Leo-Nicolle/opentone/README.md

# opentone

Work in progress.

This is a mp3 player in the style of an ipod classic. 

### Hardware
 - MCU: ESP32
 - Display: 2.2" LCD
 - SD Card: MicroSD
 - Audio: VS1063
 - Click wheel: MPR121

## License

- Software, firmware and docs: [MIT](LICENSE)
- Hardware (`hardware/`): [CERN-OHL-P v2](hardware/LICENSE)
- Third-party material (datasheets, vendor CAD models, footprints) keeps its own terms, see [THIRD_PARTY.md](THIRD_PARTY.md)
