Leo-Nicolle/opentone/hardware/opentone/3dmodels/README.md

# 3D models

These files are not covered by the project's CERN-OHL-P license. They keep their own terms.

## KiCad library models (`*.3dshapes/`, except `opentone.3dshapes/`)

Unmodified STEP models from the KiCad 3D library:

- Source: https://gitlab.com/kicad/libraries/kicad-packages3D
- Author: the KiCad library contributors
- Revision: `master` at commit `afa6aab16f43` (retrieved 2026-11-08)
- License: CC-BY-SA 4.0 with the KiCad libraries exception, see [`LICENSE.md`](LICENSE.md)
  and [`LICENSE-CC-BY-SA-4.0.txt`](LICENSE-CC-BY-SA-4.0.txt)

## Models not stored in this repository (`opentone.3dshapes/`)

EasyEDA / LCSC models, and a copy of the Alps SKQGAF model from `hardware/3dmodels/`.
Run `node scripts/fetch-3d-models.mjs` from the repository root to get them. See
[`THIRD_PARTY.md`](../../../THIRD_PARTY.md).
