Leo-Nicolle/opentone/docs/tools/clickwheel.md

---
layout: ToolLayout
sidebar: false
aside: false
---

# Click wheel designer

Shape a capacitive click wheel footprint, check how evenly neighbouring pads blend under a finger, then export the copper and outline layers for KiCad. Every size is in millimetres.

<Clickwheel />
