Leo-Nicolle/opentone/hardware/clickwheel/clickwheel-fcu-optimised.png

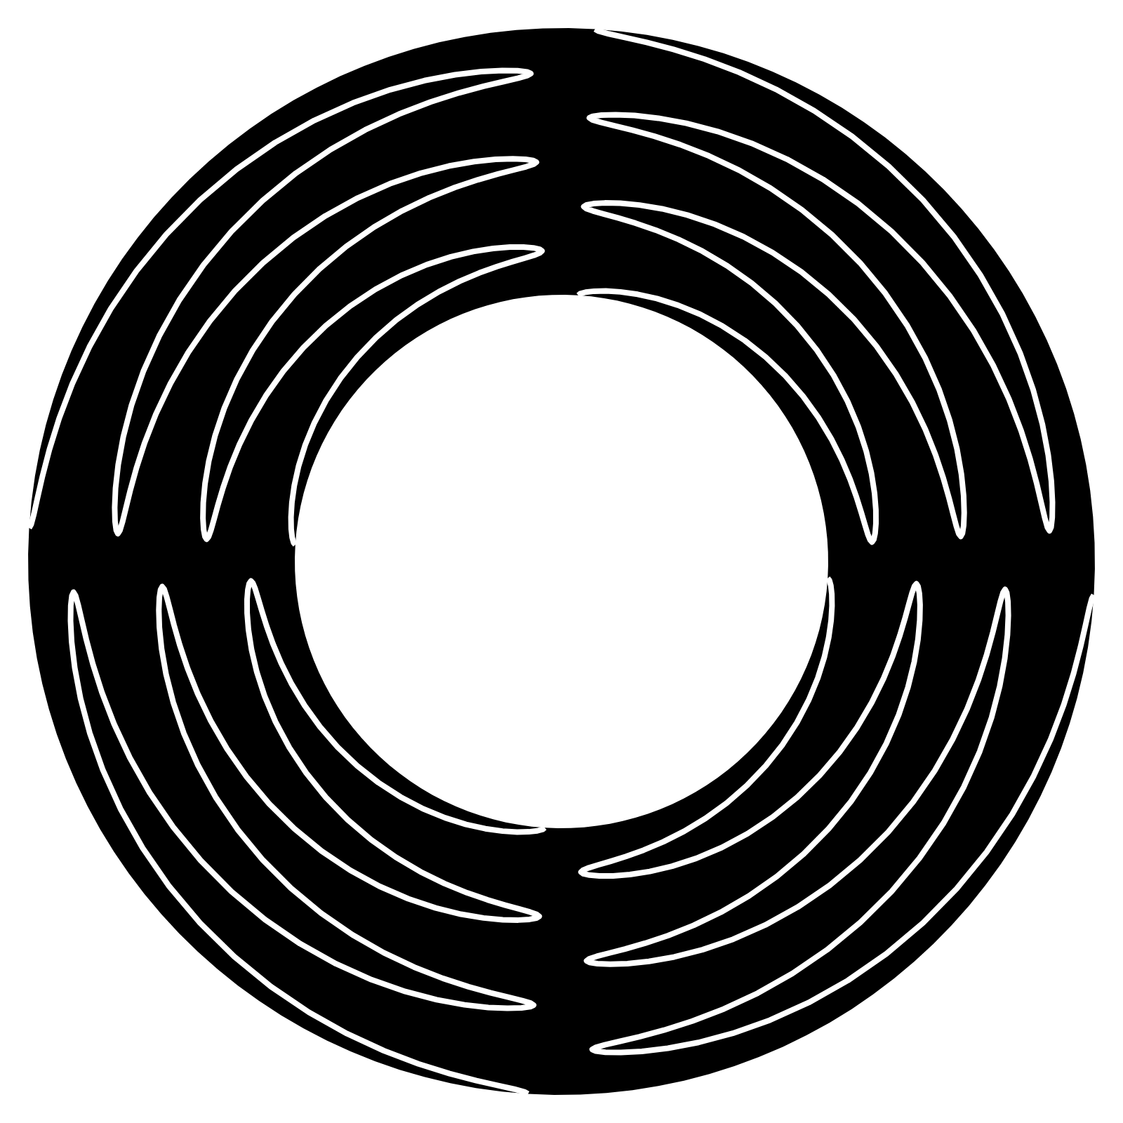
hardware/clickwheel/clickwheel-fcu-optimised.png
