Leo-Nicolle/opentone/hardware/opentone/opentone.kicad_pcb

## KiCad design hardware/opentone/opentone.kicad_pcb (2026-11-08)

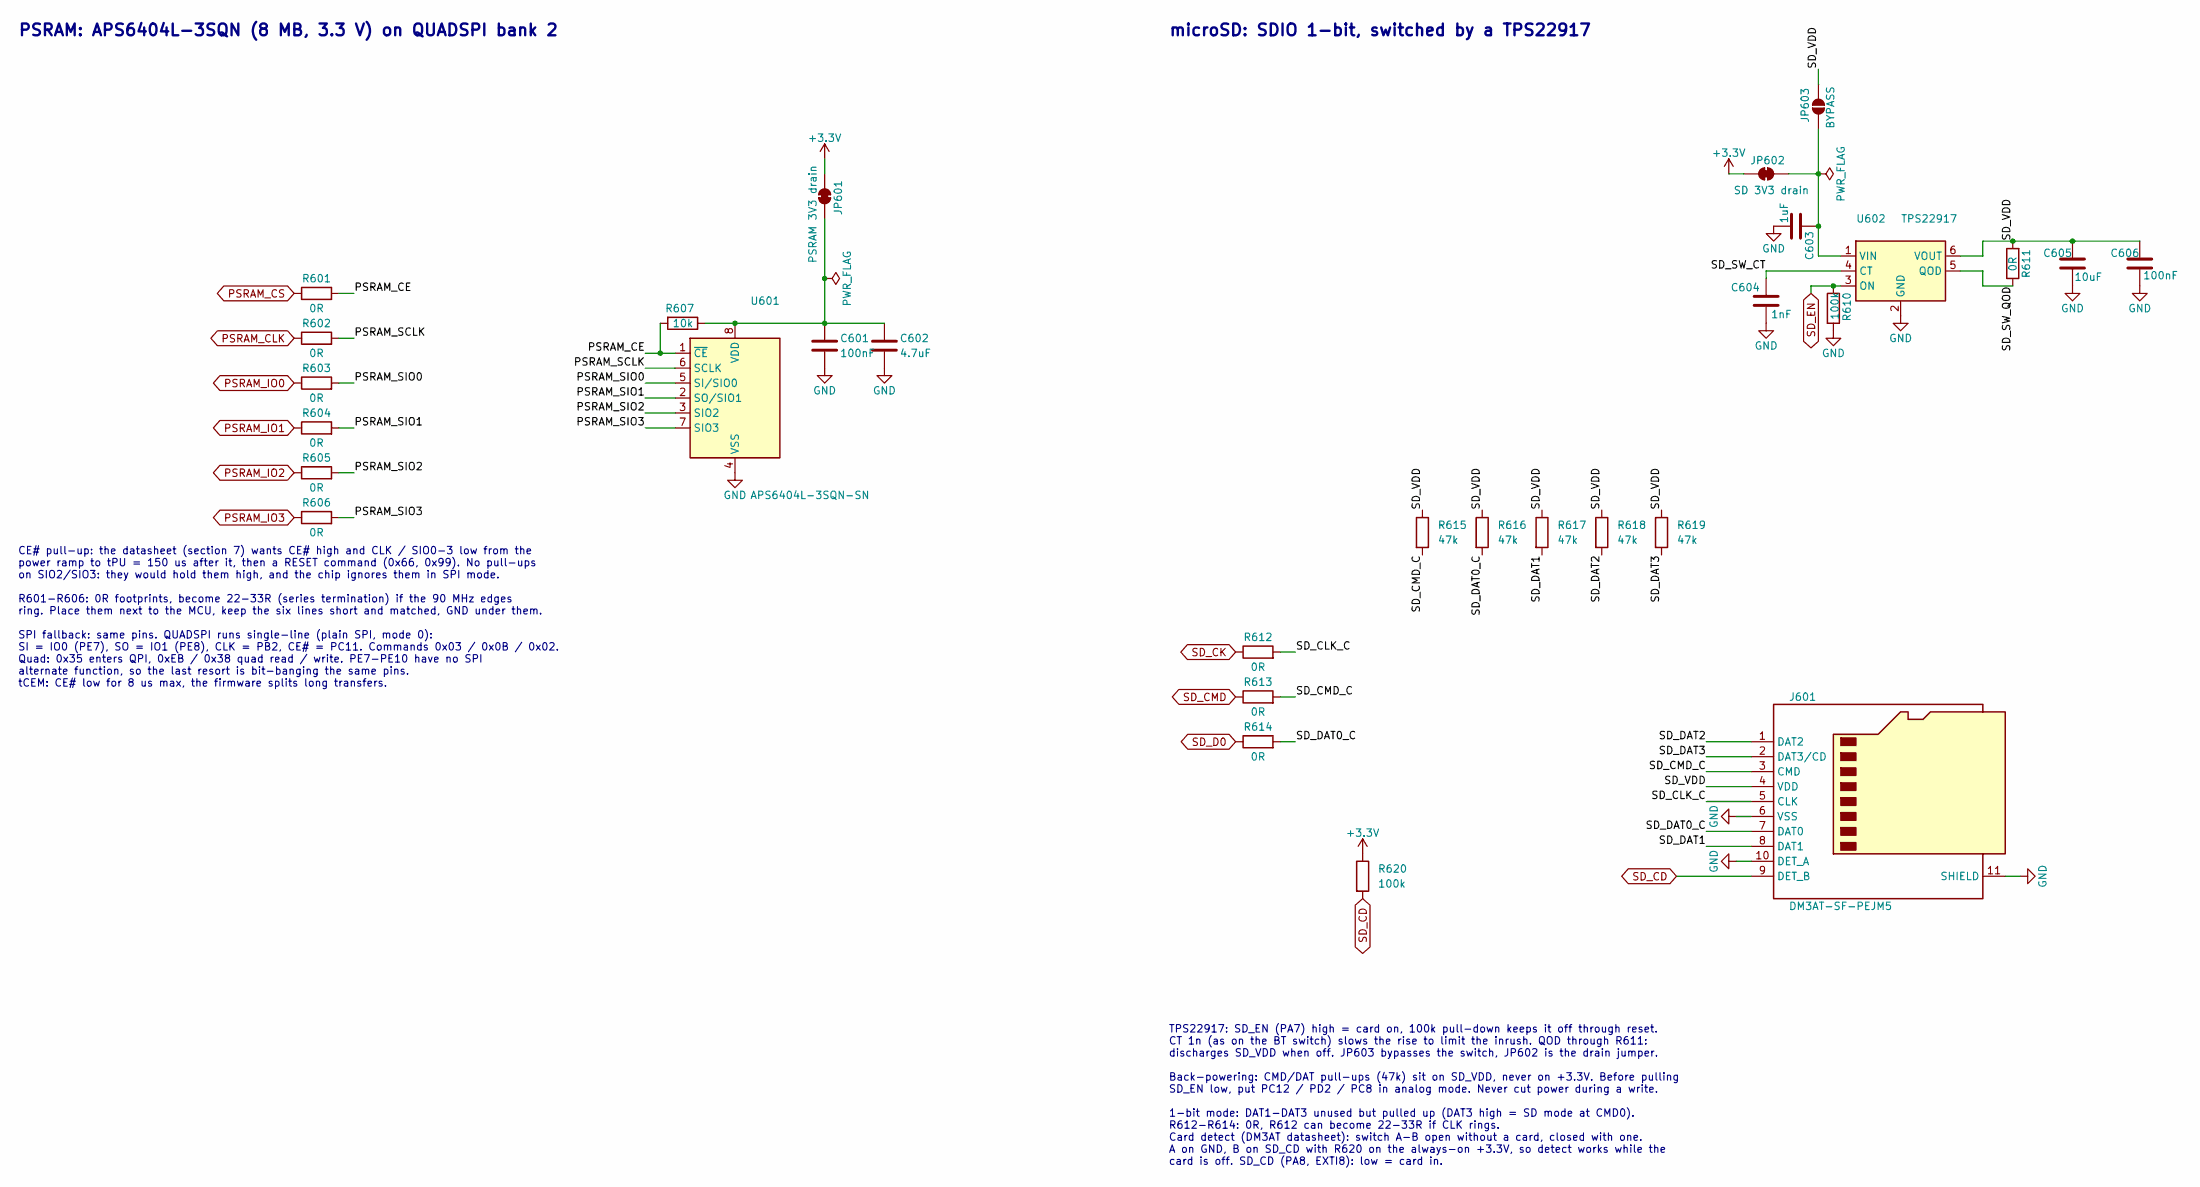
[picture p2: schematic memory.kicad_sch]

Parts:
C601, C606: 100nF; C_0603_1608Metric; Part number CC0603KRX7R9BB104; LCSC C14663
C602: 4.7uF; C_0603_1608Metric; Part number CL10A475KO8NNNC; LCSC C19666
C603: 1uF; C_0603_1608Metric; Part number CL10A105KB8NNNC; LCSC C15849
C604: 1nF; C_0603_1608Metric; Part number CL10B102KB8NNNC; LCSC C1588
C605: 10uF; C_0603_1608Metric; Part number CL10A106KP8NNNC; LCSC C19702
J601: DM3AT-SF-PEJM5; microSD_HC_Hirose_DM3AT-SF-PEJM5; Part number DM3AT-SF-PEJM5; LCSC C114218
JP601: PSRAM 3V3 drain; SolderJumper-2_P1.3mm_Bridged_RoundedPad1.0x1.5mm
JP602: SD 3V3 drain; SolderJumper-2_P1.3mm_Bridged_RoundedPad1.0x1.5mm
JP603: BYPASS; SolderJumper-2_P1.3mm_Open_RoundedPad1.0x1.5mm
R601, R602, R603, R604, R605, R606, R611, R612, R613, R614: 0R; R_0603_1608Metric; Part number 0603WAF0000T5E; LCSC C21189
R607: 10k; R_0603_1608Metric; Part number 0603WAF1002T5E; LCSC C25804
R610, R620: 100k; R_0603_1608Metric; Part number 0603WAF1003T5E; LCSC C25803
R615, R616, R617, R618, R619: 47k; R_0603_1608Metric; Part number 0603WAF4702T5E; LCSC C25819
U601: APS6404L-3SQN-SN; SOIC-8_3.9x4.9mm_P1.27mm; Part number APS6404L-3SQN-SN; LCSC C3028887
U602: TPS22917; SOT-23-6; Part number TPS22917DBVR; LCSC C2681320

Connections:
+3.3V: JP601.1 (A), JP602.1 (A), R620.1; also elsewhere on the board
/Memory/PSRAM_CE: R601.2, R607.2, U601.1 (~CE)
/Memory/PSRAM_SCLK: R602.2, U601.6 (SCLK)
/Memory/PSRAM_SIO0: R603.2, U601.5 (SI/SIO0)
/Memory/PSRAM_SIO1: R604.2, U601.2 (SO/SIO1)
/Memory/PSRAM_SIO2: R605.2, U601.3 (SIO2)
/Memory/PSRAM_SIO3: R606.2, U601.7 (SIO3)
/Memory/SD_CLK_C: J601.5 (CLK), R612.2
/Memory/SD_CMD_C: J601.3 (CMD), R613.2, R615.2
/Memory/SD_DAT0_C: J601.7 (DAT0), R614.2, R616.2
/Memory/SD_DAT1: J601.8 (DAT1), R617.2
/Memory/SD_DAT2: J601.1 (DAT2), R618.2
/Memory/SD_DAT3: J601.2 (DAT3/CD), R619.2
/Memory/SD_SW_CT: C604.1, U602.4 (CT)
/Memory/SD_SW_QOD: R611.1, U602.5 (QOD)
/Memory/SD_VDD: C605.1, C606.1, J601.4 (VDD), JP603.2 (B), R611.2, R615.1, R616.1, R617.1, R618.1, R619.1, U602.6 (VOUT)
GND: C601.2, C602.2, C603.2, C604.2, C605.2, C606.2, J601.6 (VSS), J601.10 (DET_A), J601.11 (SHIELD), R610.2, U601.4 (VSS), U602.2 (GND); also elsewhere on the board
unnamed: C601.1, C602.1, JP601.2 (B), R607.1, U601.8 (VDD)
unnamed: C603.1, JP602.2 (B), JP603.1 (A), U602.1 (VIN)
PSRAM_CLK: R602.1; also elsewhere on the board
PSRAM_CS: R601.1; also elsewhere on the board
PSRAM_IO0: R603.1; also elsewhere on the board
PSRAM_IO1: R604.1; also elsewhere on the board
PSRAM_IO2: R605.1; also elsewhere on the board
PSRAM_IO3: R606.1; also elsewhere on the board
SD_CD: J601.9 (DET_B), R620.2; also elsewhere on the board
SD_CK: R612.1; also elsewhere on the board
SD_CMD: R613.1; also elsewhere on the board
SD_D0: R614.1; also elsewhere on the board
SD_EN: R610.1, U602.3 (ON); also elsewhere on the board

Notes on the sheet:
microSD: SDIO 1-bit, switched by a TPS22917
TPS22917: SD_EN (PA7) high = card on, 100k pull-down keeps it off through reset. CT 1n (as on the BT switch) slows the rise to limit the inrush. QOD through R611: discharges SD_VDD when off. JP603 bypasses the switch, JP602 is the drain jumper. Back-powering: CMD/DAT pull-ups (47k) sit on SD_VDD, n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
CE# pull-up: the datasheet (section 7) wants CE# high and CLK / SIO0-3 low from the power ramp to tPU = 150 us after it, then a RESET command (0x66, 0x99). No pull-ups on SIO2/SIO3: they would hold them high, and the chip ignores them in SPI mode. R601-R606: 0R footprints, become 22-33R (series ter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
PSRAM: APS6404L-3SQN (8 MB, 3.3 V) on QUADSPI bank 2

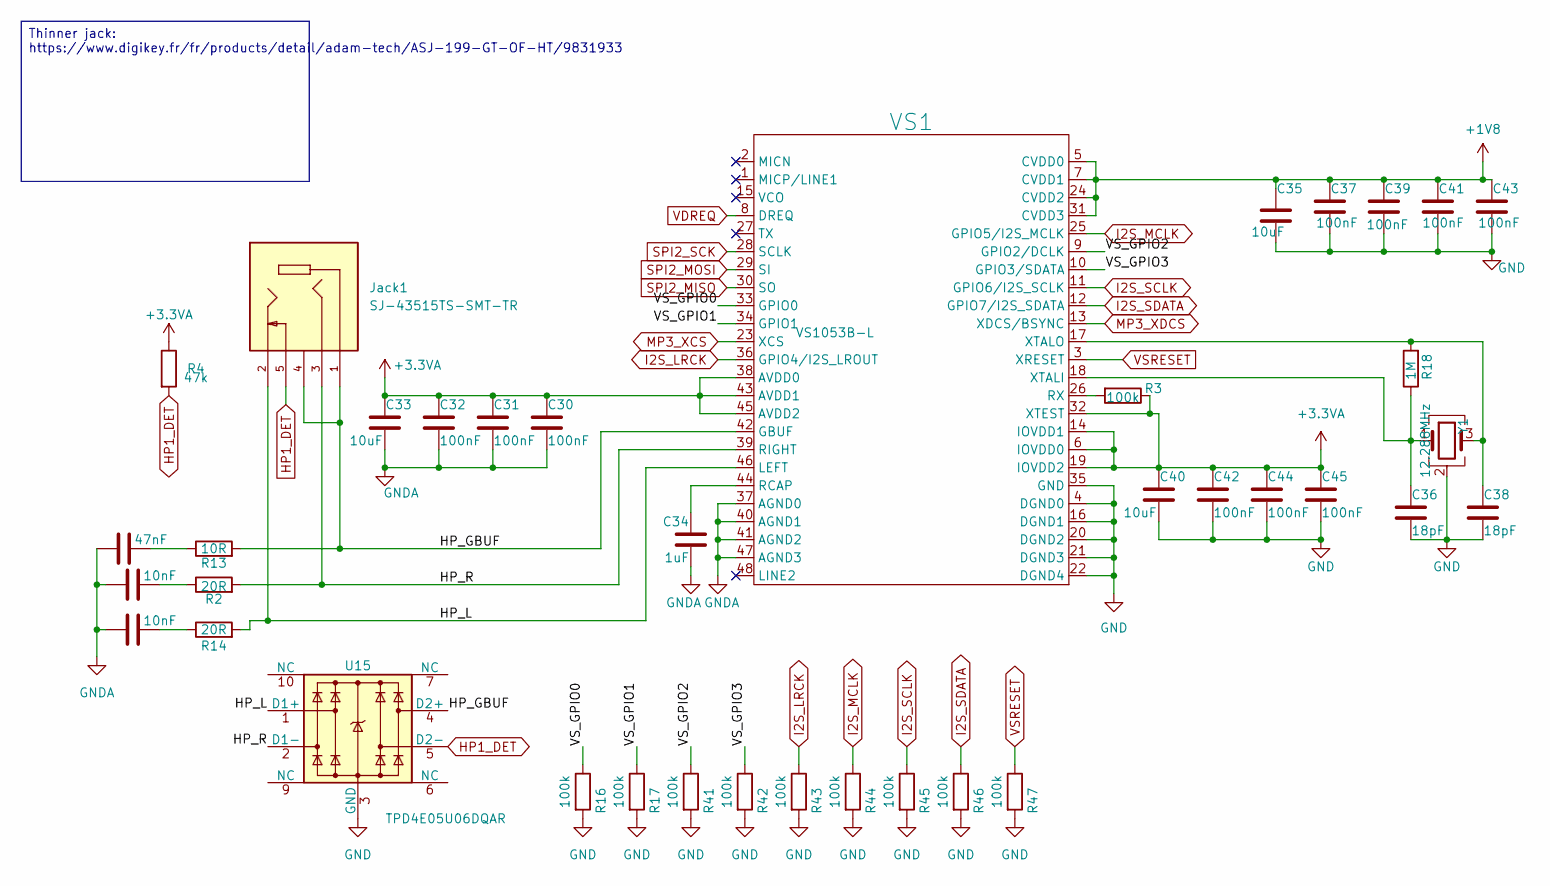
[picture p3: schematic audio.kicad_sch]

Parts:
C3, C29: 10nF; C_0603_1608Metric; Part number GRM1885C1H103JA01D; LCSC C85973
C9: 47nF; C_1206_3216Metric; Part number GRM31M5C1H473JA01L; LCSC C21812
C30, C31, C37, C39, C41, C42, C43, C44, C45: 100nF; C_0603_1608Metric; Part number CC0603KRX7R9BB104; LCSC C14663
C32: 100nF; C_0402_1005Metric; Part number CL05B104KO5NNNC; LCSC C1525
C33, C35, C40: 10uF; C_0603_1608Metric; Part number CL10A106KP8NNNC; LCSC C19702
C34: 1uF; C_0603_1608Metric; Part number CL10A105KB8NNNC; LCSC C15849
C36, C38: 18pF; C_0603_1608Metric; Part number CL10C180JB8NNNC; LCSC C1647
Jack1: SJ-43515TS-SMT-TR; CUI_SJ-43515TS-SMT-TR; Part number SJ-43515TS-SMT-TR; LCSC C5353507
R2, R14: 20R; R_0603_1608Metric; Part number 0603WAF200JT5E; LCSC C22950
R3, R16, R17, R41, R42, R43, R44, R45, R46, R47: 100k; R_0603_1608Metric; Part number 0603WAF1003T5E; LCSC C25803
R4: 47k; R_0603_1608Metric; Part number 0603WAF4702T5E; LCSC C25819
R13: 10R; R_0603_1608Metric; Part number 0603WAF100JT5E; LCSC C22859
R18: 1M; R_0603_1608Metric; Part number 0603WAF1004T5E; LCSC C22935
U15: TPD4E05U06DQAR; USON-10_2.5x1.0mm_P0.5mm; Part number TPD4E05U06DQAR; LCSC C138714
VS1: VS1053B-L; LQFP-48_7x7mm_P0.5mm; Part number VS1053B-L; LCSC C9922
Y1: 12.288MHz; Crystal_SMD_3225-4Pin_3.2x2.5mm; Part number TXM12.288M0004322FBCDO00T; LCSC C362472

Connections:
+1V8: C35.1, C37.1, C39.1, C41.1, C43.1, VS1.5 (CVDD0), VS1.7 (CVDD1), VS1.24 (CVDD2), VS1.31 (CVDD3); also elsewhere on the board
+3.3VA: C30.1, C31.1, C32.1, C33.1, C40.1, C42.1, C44.1, C45.1, R3.1, R4.1, VS1.6 (IOVDD0), VS1.14 (IOVDD1), VS1.19 (IOVDD2), VS1.32 (XTEST), VS1.38 (AVDD0), VS1.43 (AVDD1), VS1.45 (AVDD2); also elsewhere on the board
/Audio/HP_GBUF: Jack1.1, Jack1.4, R13.2, U15.4 (D2+), VS1.42 (GBUF)
/Audio/HP_L: Jack1.2, R14.2, U15.1 (D1+), VS1.46 (LEFT)
/Audio/HP_R: Jack1.3, R2.2, U15.2 (D1-), VS1.39 (RIGHT)
/Audio/VS_GPIO0: R16.1, VS1.33 (GPIO0)
/Audio/VS_GPIO1: R17.1, VS1.34 (GPIO1)
/Audio/VS_GPIO2: R41.1, VS1.9 (GPIO2/DCLK)
/Audio/VS_GPIO3: R42.1, VS1.10 (GPIO3/SDATA)
GND: C35.2, C36.2, C37.2, C38.2, C39.2, C40.2, C41.2, C42.2, C43.2, C44.2, C45.2, R16.2, R17.2, R41.2, R42.2, R43.2, R44.2, R45.2, R46.2, R47.2, U15.3 (GND), U15.8 (GND), VS1.4 (DGND0), VS1.16 (DGND1), VS1.20 (DGND2), VS1.21 (DGND3), VS1.22 (DGND4), VS1.35 (GND), Y1.2 (G), Y1.4 (G); also elsewhere on the board
GNDA: C3.1, C9.1, C29.1, C30.2, C31.2, C32.2, C33.2, C34.2, VS1.37 (AGND0), VS1.40 (AGND1), VS1.41 (AGND2), VS1.47 (AGND3); also elsewhere on the board
HP1_DET: Jack1.5, R4.2, U15.5 (D2-); also elsewhere on the board
I2S_LRCK: R43.1, VS1.36 (GPIO4/I2S_LROUT); also elsewhere on the board
I2S_MCLK: R44.1, VS1.25 (GPIO5/I2S_MCLK); also elsewhere on the board
I2S_SCLK: R45.1, VS1.11 (GPIO6/I2S_SCLK); also elsewhere on the board
I2S_SDATA: R46.1, VS1.12 (GPIO7/I2S_SDATA); also elsewhere on the board
MP3_XCS: VS1.23 (XCS); also elsewhere on the board
MP3_XDCS: VS1.13 (XDCS/BSYNC); also elsewhere on the board
unnamed: C3.2, R2.1
unnamed: C9.2, R13.1
unnamed: C29.2, R14.1
unnamed: C34.1, VS1.44 (RCAP)
unnamed: R3.2, VS1.26 (RX)
unnamed: C36.1, R18.1, VS1.18 (XTALI), Y1.1
unnamed: C38.1, R18.2, VS1.17 (XTALO), Y1.3
SPI2_MISO: VS1.30 (SO); also elsewhere on the board
SPI2_MOSI: VS1.29 (SI); also elsewhere on the board
SPI2_SCK: VS1.28 (SCLK); also elsewhere on the board
VDREQ: VS1.8 (DREQ); also elsewhere on the board
VSRESET: R47.1, VS1.3 (XRESET); also elsewhere on the board

Notes on the sheet:
Thinner jack: https://www.digikey.fr/fr/products/detail/adam-tech/ASJ-199-GT-OF-HT/9831933

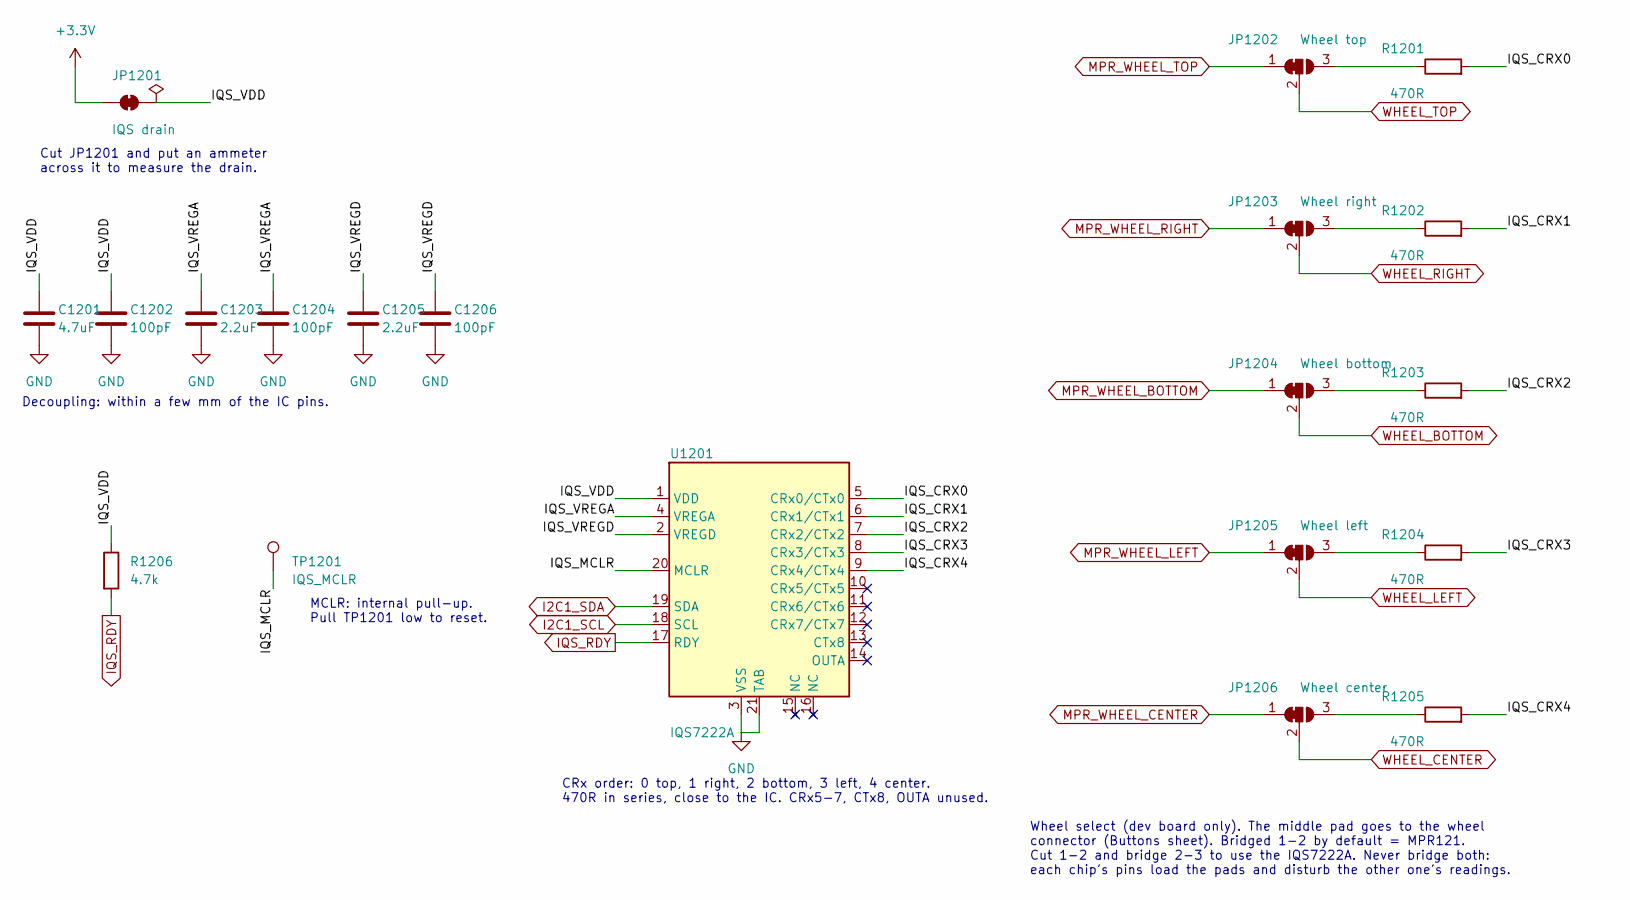
[picture p4: schematic touch.kicad_sch]

Parts:
C1201: 4.7uF; C_0603_1608Metric; Part number CL10A475KO8NNNC; LCSC C19666
C1202, C1204, C1206: 100pF; C_0603_1608Metric; Part number CL10C101JB8NNNC; LCSC C14858
C1203, C1205: 2.2uF; C_0603_1608Metric; Part number CL10A225KO8NNNC; LCSC C23630
JP1201: IQS drain; SolderJumper-2_P1.3mm_Bridged_RoundedPad1.0x1.5mm
JP1202: Wheel top; SolderJumper-3_P1.3mm_Bridged12_RoundedPad1.0x1.5mm
JP1203: Wheel right; SolderJumper-3_P1.3mm_Bridged12_RoundedPad1.0x1.5mm
JP1204: Wheel bottom; SolderJumper-3_P1.3mm_Bridged12_RoundedPad1.0x1.5mm
JP1205: Wheel left; SolderJumper-3_P1.3mm_Bridged12_RoundedPad1.0x1.5mm
JP1206: Wheel center; SolderJumper-3_P1.3mm_Bridged12_RoundedPad1.0x1.5mm
R1201, R1202, R1203, R1204, R1205: 470R; R_0603_1608Metric; Part number 0603WAF4700T5E; LCSC C23179
R1206: 4.7k; R_0603_1608Metric; Part number 0603WAF4701T5E; LCSC C23162
TP1201: IQS_MCLR; TestPoint_Pad_D1.0mm
U1201: IQS7222A; VQFN-20-1EP_3x3mm_P0.4mm_EP1.7x1.7mm; Part number IQS7222A001QNR; LCSC C3827627

Connections:
+3.3V: JP1201.1 (A); also elsewhere on the board
/Touch/IQS_CRX0: R1201.2, U1201.5 (CRx0/CTx0)
/Touch/IQS_CRX1: R1202.2, U1201.6 (CRx1/CTx1)
/Touch/IQS_CRX2: R1203.2, U1201.7 (CRx2/CTx2)
/Touch/IQS_CRX3: R1204.2, U1201.8 (CRx3/CTx3)
/Touch/IQS_CRX4: R1205.2, U1201.9 (CRx4/CTx4)
/Touch/IQS_MCLR: TP1201.1 (1_1), U1201.20 (MCLR)
/Touch/IQS_VDD: C1201.1, C1202.1, JP1201.2 (B), R1206.1, U1201.1 (VDD)
/Touch/IQS_VREGA: C1203.1, C1204.1, U1201.4 (VREGA)
/Touch/IQS_VREGD: C1205.1, C1206.1, U1201.2 (VREGD)
GND: C1201.2, C1202.2, C1203.2, C1204.2, C1205.2, C1206.2, U1201.3 (VSS), U1201.21 (TAB); also elsewhere on the board
I2C1_SCL: U1201.18 (SCL); also elsewhere on the board
I2C1_SDA: U1201.19 (SDA); also elsewhere on the board
IQS_RDY: R1206.2, U1201.17 (RDY); also elsewhere on the board
MPR_WHEEL_BOTTOM: JP1204.1 (A); also elsewhere on the board
MPR_WHEEL_CENTER: JP1206.1 (A); also elsewhere on the board
MPR_WHEEL_LEFT: JP1205.1 (A); also elsewhere on the board
MPR_WHEEL_RIGHT: JP1203.1 (A); also elsewhere on the board
MPR_WHEEL_TOP: JP1202.1 (A); also elsewhere on the board
unnamed: JP1202.3 (B), R1201.1
unnamed: JP1203.3 (B), R1202.1
unnamed: JP1204.3 (B), R1203.1
unnamed: JP1205.3 (B), R1204.1
unnamed: JP1206.3 (B), R1205.1
WHEEL_BOTTOM: JP1204.2 (C); also elsewhere on the board
WHEEL_CENTER: JP1206.2 (C); also elsewhere on the board
WHEEL_LEFT: JP1205.2 (C); also elsewhere on the board
WHEEL_RIGHT: JP1203.2 (C); also elsewhere on the board
WHEEL_TOP: JP1202.2 (C); also elsewhere on the board

Notes on the sheet:
MCLR: internal pull-up. Pull TP1201 low to reset.
Decoupling: within a few mm of the IC pins.
CRx order: 0 top, 1 right, 2 bottom, 3 left, 4 center. 470R in series, close to the IC. CRx5-7, CTx8, OUTA unused.
Cut JP1201 and put an ammeter across it to measure the drain.
Wheel select (dev board only). The middle pad goes to the wheel connector (Buttons sheet). Bridged 1-2 by default = MPR121. Cut 1-2 and bridge 2-3 to use the IQS7222A. Never bridge both: each chip's pins load the pads and disturb the other one's readings.

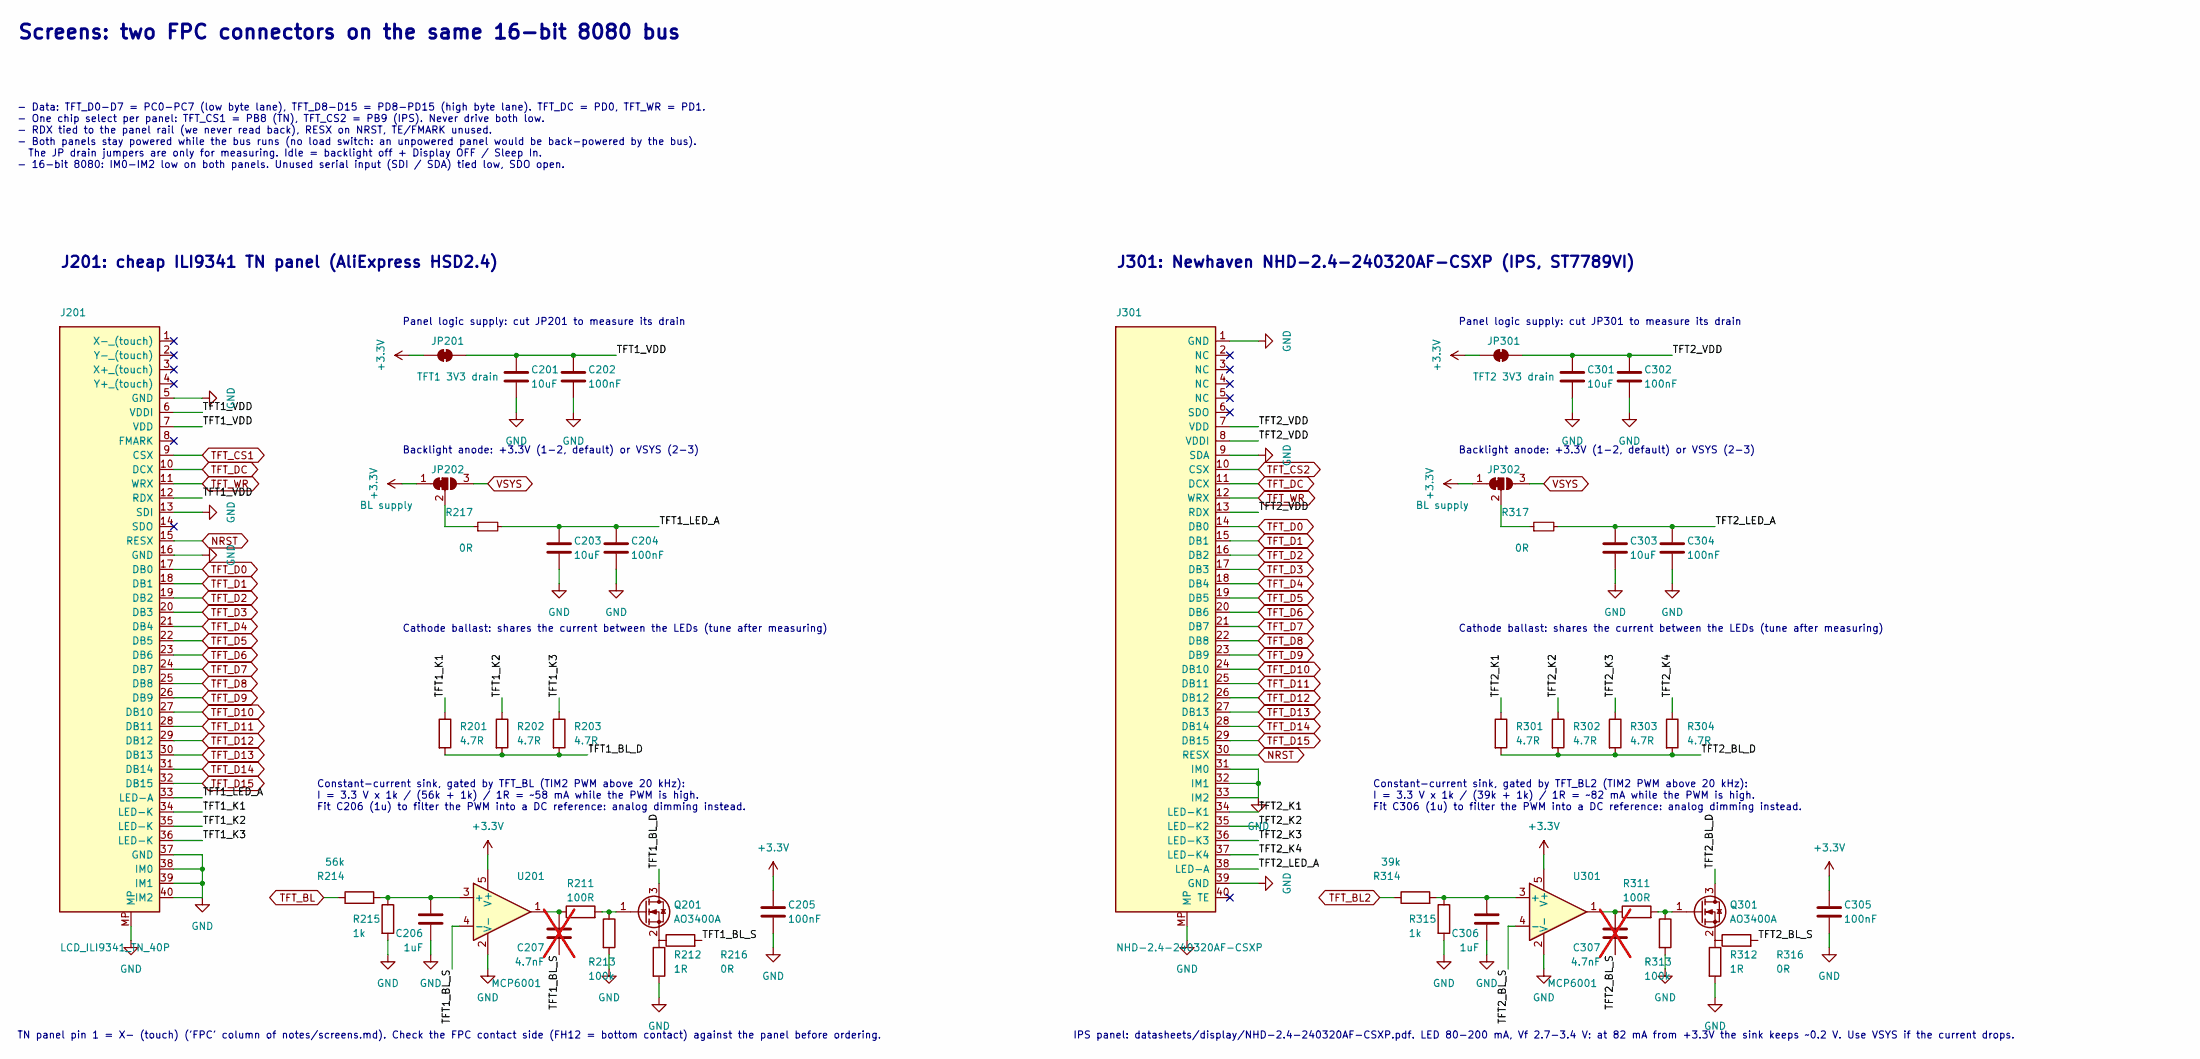
[picture p5: schematic screens.kicad_sch]

Parts:
C201, C301: 10uF; C_0603_1608Metric; Part number CL10A106KP8NNNC; LCSC C19702
C202, C204, C205, C302, C304, C305: 100nF; C_0603_1608Metric; Part number CC0603KRX7R9BB104; LCSC C14663
C203, C303: 10uF; C_0603_1608Metric; Part number CL10A106MA8NRNC; LCSC C96446
C206, C306: 1uF; C_0603_1608Metric; Part number CL10A105KB8NNNC; LCSC C15849
C207, C307: 4.7nF; C_0603_1608Metric; Part number 0603B472K500NT; LCSC C53987; not fitted
J201: LCD_ILI9341_TN_40P; Hirose_FH12-40S-0.5SH_1x40-1MP_P0.50mm_Horizontal; Part number FH12-40S-0.5SH(55); LCSC C202114
J301: NHD-2.4-240320AF-CSXP; Hirose_FH12-40S-0.5SH_1x40-1MP_P0.50mm_Horizontal; Part number FH12-40S-0.5SH(55); LCSC C202114
JP201: TFT1 3V3 drain; SolderJumper-2_P1.3mm_Bridged_RoundedPad1.0x1.5mm
JP202, JP302: BL supply; SolderJumper-3_P1.3mm_Bridged12_RoundedPad1.0x1.5mm
JP301: TFT2 3V3 drain; SolderJumper-2_P1.3mm_Bridged_RoundedPad1.0x1.5mm
Q201, Q301: AO3400A; SOT-23; Part number AO3400A; LCSC C20917
R201, R202, R203, R301, R302, R303, R304: 4.7R; R_0603_1608Metric; Part number 0603WAF470KT5E; LCSC C23164
R211, R311: 100R; R_0603_1608Metric; Part number 0603WAF1000T5E; LCSC C22775
R212, R312: 1R; R_0603_1608Metric; Part number 0603WAF100KT5E; LCSC C22936
R213, R313: 100k; R_0603_1608Metric; Part number 0603WAF1003T5E; LCSC C25803
R214: 56k; R_0603_1608Metric; Part number 0603WAF5602T5E; LCSC C23206
R215, R315: 1k; R_0603_1608Metric; Part number 0603WAF1001T5E; LCSC C21190
R216, R217, R316, R317: 0R; R_0603_1608Metric; Part number 0603WAF0000T5E; LCSC C21189
R314: 39k; R_0603_1608Metric; Part number 0603WAF3902T5E; LCSC C23153
U201, U301: MCP6001; SOT-23-5; Part number MCP6001T-I/OT; LCSC C116490

Connections:
+3.3V: C205.1, C305.1, JP201.1 (A), JP202.1 (A), JP301.1 (A), JP302.1 (A), U201.5 (V+), U301.5 (V+); also elsewhere on the board
/Screens/TFT1_BL_D: Q201.3 (D), R201.2, R202.2, R203.2
/Screens/TFT1_BL_S: C207.2, R216.2, U201.4 (-)
/Screens/TFT1_K1: J201.34 (LED-K), R201.1
/Screens/TFT1_K2: J201.35 (LED-K), R202.1
/Screens/TFT1_K3: J201.36 (LED-K), R203.1
/Screens/TFT1_LED_A: C203.1, C204.1, J201.33 (LED-A), R217.2
/Screens/TFT1_VDD: C201.1, C202.1, J201.6 (VDDI), J201.7 (VDD), J201.12 (RDX), JP201.2 (B)
/Screens/TFT2_BL_D: Q301.3 (D), R301.2, R302.2, R303.2, R304.2
/Screens/TFT2_BL_S: C307.2, R316.2, U301.4 (-)
/Screens/TFT2_K1: J301.34 (LED-K1), R301.1
/Screens/TFT2_K2: J301.35 (LED-K2), R302.1
/Screens/TFT2_K3: J301.36 (LED-K3), R303.1
/Screens/TFT2_K4: J301.37 (LED-K4), R304.1
/Screens/TFT2_LED_A: C303.1, C304.1, J301.38 (LED-A), R317.2
/Screens/TFT2_VDD: C301.1, C302.1, J301.7 (VDD), J301.8 (VDDI), J301.13 (RDX), JP301.2 (B)
GND: C201.2, C202.2, C203.2, C204.2, C205.2, C206.2, C301.2, C302.2, C303.2, C304.2, C305.2, C306.2, J201.5 (GND), J201.13 (SDI), J201.16 (GND), J201.37 (GND), J201.38 (IM0), J201.39 (IM1), J201.40 (IM2), J201.MP, J301.1 (GND), J301.9 (SDA), J301.31 (IM0), J301.32 (IM1), J301.33 (IM2), J301.39 (GND), J301.MP, R212.2, R213.2, R215.2, R312.2, R313.2, R315.2, U201.2 (V-), U301.2 (V-); also elsewhere on the board
NRST: J201.15 (RESX), J301.30 (RESX); also elsewhere on the board
unnamed: C207.1, R211.1, U201.1
unnamed: C307.1, R311.1, U301.1
unnamed: JP202.2 (C), R217.1
unnamed: JP302.2 (C), R317.1
unnamed: Q201.1 (G), R211.2, R213.1
unnamed: Q201.2 (S), R212.1, R216.1
unnamed: Q301.1 (G), R311.2, R313.1
unnamed: Q301.2 (S), R312.1, R316.1
unnamed: C206.1, R214.2, R215.1, U201.3 (+)
unnamed: C306.1, R314.2, R315.1, U301.3 (+)
TFT_BL: R214.1; also elsewhere on the board
TFT_BL2: R314.1; also elsewhere on the board
TFT_CS1: J201.9 (CSX); also elsewhere on the board
TFT_CS2: J301.10 (CSX); also elsewhere on the board
TFT_D0: J201.17 (DB0), J301.14 (DB0); also elsewhere on the board
TFT_D1: J201.18 (DB1), J301.15 (DB1); also elsewhere on the board
TFT_D2: J201.19 (DB2), J301.16 (DB2); also elsewhere on the board
TFT_D3: J201.20 (DB3), J301.17 (DB3); also elsewhere on the board
TFT_D4: J201.21 (DB4), J301.18 (DB4); also elsewhere on the board
TFT_D5: J201.22 (DB5), J301.19 (DB5); also elsewhere on the board
TFT_D6: J201.23 (DB6), J301.20 (DB6); also elsewhere on the board
TFT_D7: J201.24 (DB7), J301.21 (DB7); also elsewhere on the board
TFT_D8: J201.25 (DB8), J301.22 (DB8); also elsewhere on the board
TFT_D9: J201.26 (DB9), J301.23 (DB9); also elsewhere on the board
TFT_D10: J201.27 (DB10), J301.24 (DB10); also elsewhere on the board
TFT_D11: J201.28 (DB11), J301.25 (DB11); also elsewhere on the board
TFT_D12: J201.29 (DB12), J301.26 (DB12); also elsewhere on the board
TFT_D13: J201.30 (DB13), J301.27 (DB13); also elsewhere on the board
TFT_D14: J201.31 (DB14), J301.28 (DB14); also elsewhere on the board
TFT_D15: J201.32 (DB15), J301.29 (DB15); also elsewhere on the board
TFT_DC: J201.10 (DCX), J301.11 (DCX); also elsewhere on the board
TFT_WR: J201.11 (WRX), J301.12 (WRX); also elsewhere on the board
VSYS: JP202.3 (B), JP302.3 (B); also elsewhere on the board

Notes on the sheet:
Panel logic supply: cut JP201 to measure its drain
TN panel pin 1 = X- (touch) ('FPC' column of notes/screens.md). Check the FPC contact side (FH12 = bottom contact) against the panel before ordering.
Backlight anode: +3.3V (1-2, default) or VSYS (2-3)
- Data: TFT_D0-D7 = PC0-PC7 (low byte lane), TFT_D8-D15 = PD8-PD15 (high byte lane). TFT_DC = PD0, TFT_WR = PD1. - One chip select per panel: TFT_CS1 = PB8 (TN), TFT_CS2 = PB9 (IPS). Never drive both low. - RDX tied to the panel rail (we never read back), RESX on NRST, TE/FMARK unused. - Both panel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
Constant-current sink, gated by TFT_BL (TIM2 PWM above 20 kHz): I = 3.3 V x 1k / (56k + 1k) / 1R = ~58 mA while the PWM is high. Fit C206 (1u) to filter the PWM into a DC reference: analog dimming instead.
Screens: two FPC connectors on the same 16-bit 8080 bus
IPS panel: datasheets/display/NHD-2.4-240320AF-CSXP.pdf. LED 80-200 mA, Vf 2.7-3.4 V: at 82 mA from +3.3V the sink keeps ~0.2 V. Use VSYS if the current drops.
Panel logic supply: cut JP301 to measure its drain
J201: cheap ILI9341 TN panel (AliExpress HSD2.4)
Constant-current sink, gated by TFT_BL2 (TIM2 PWM above 20 kHz): I = 3.3 V x 1k / (39k + 1k) / 1R = ~82 mA while the PWM is high. Fit C306 (1u) to filter the PWM into a DC reference: analog dimming instead.
J301: Newhaven NHD-2.4-240320AF-CSXP (IPS, ST7789VI)
Cathode ballast: shares the current between the LEDs (tune after measuring)

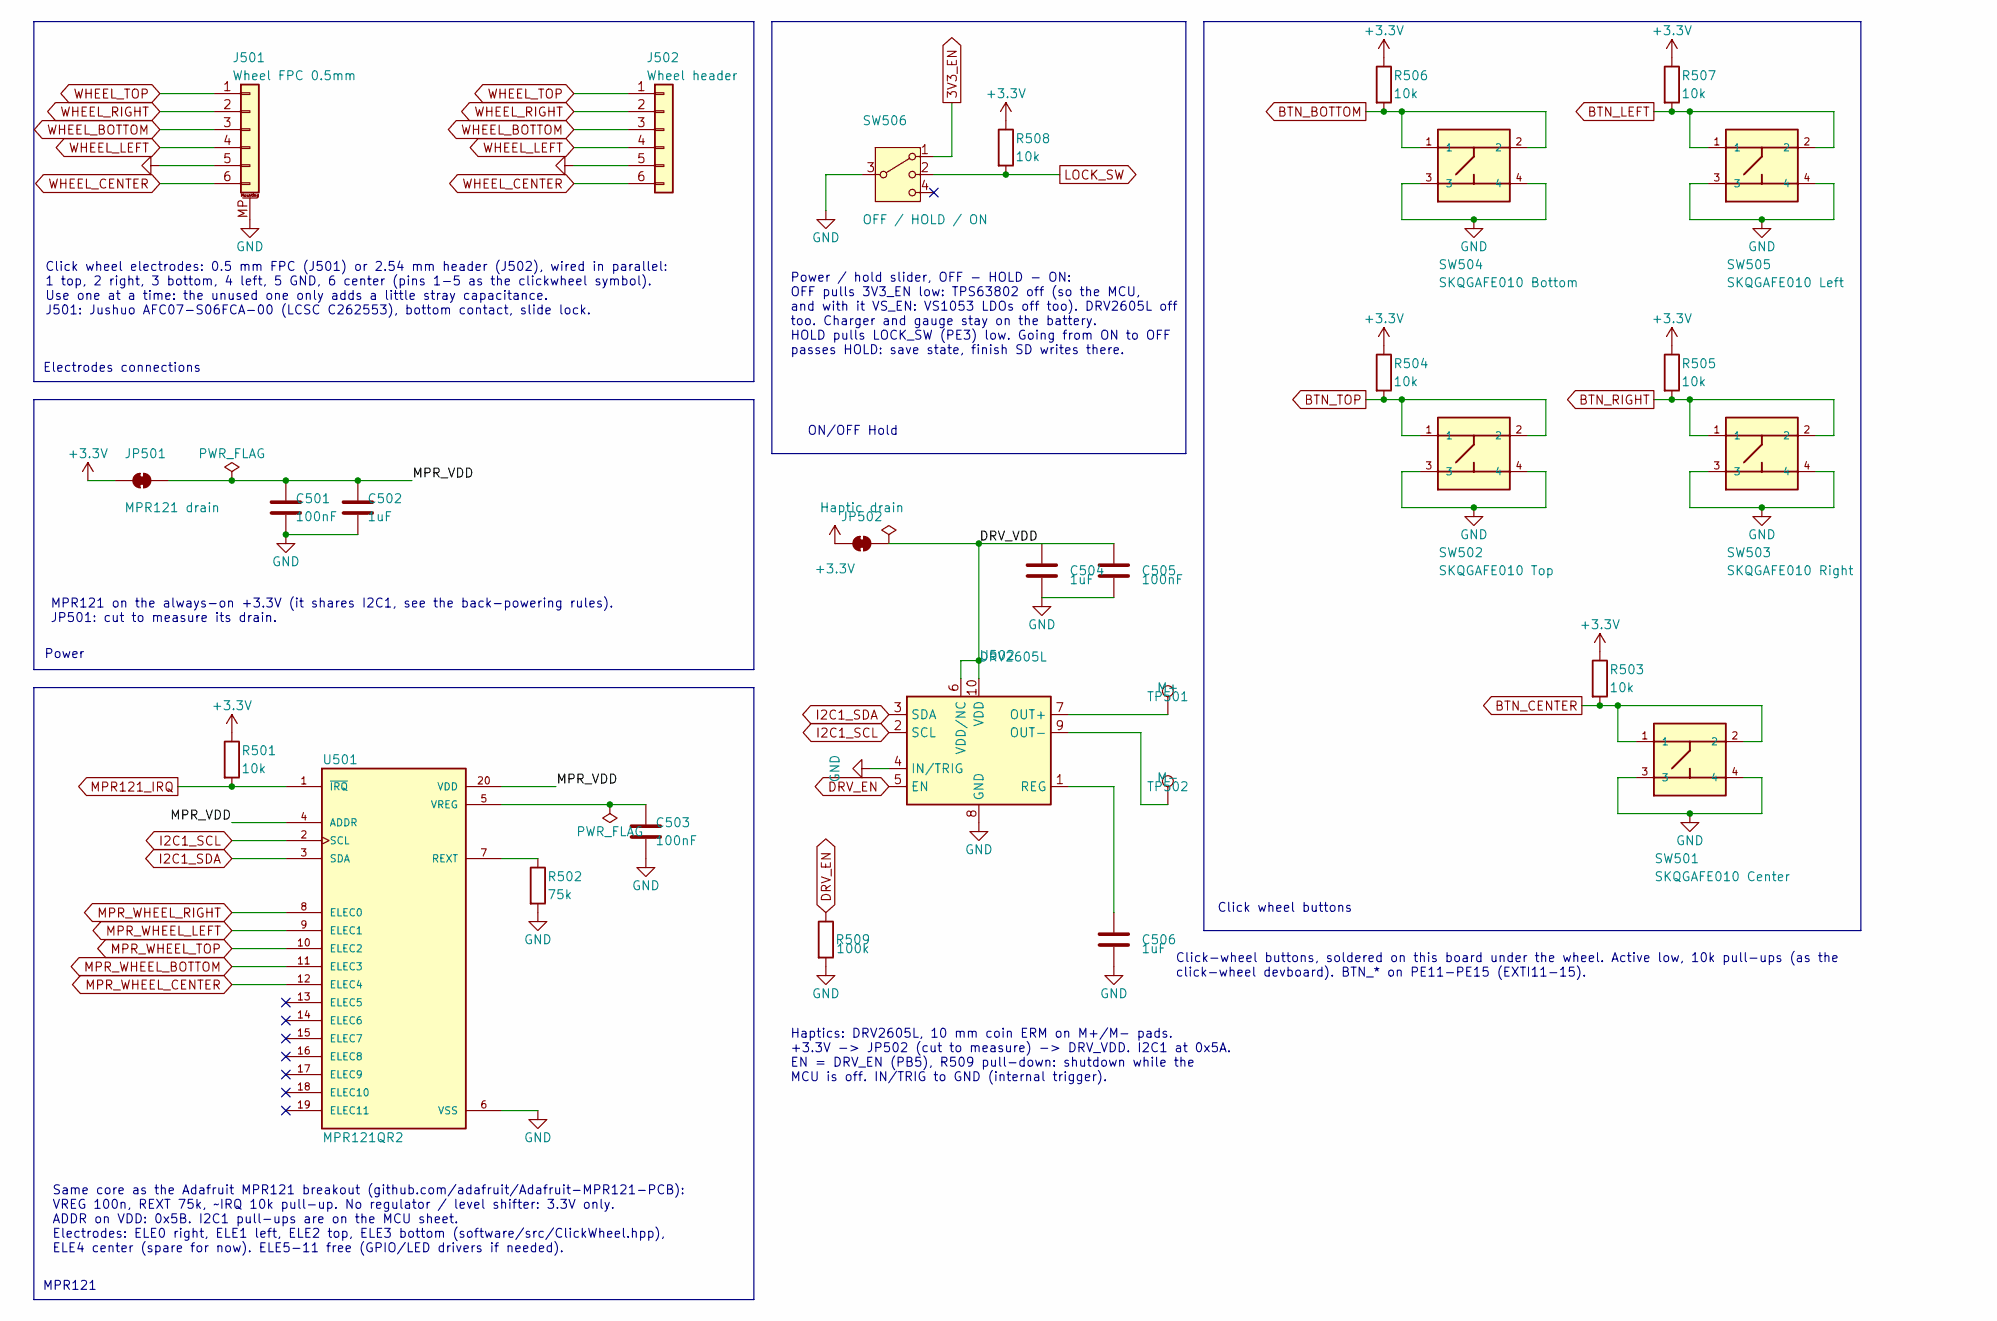
[picture p6: schematic buttons.kicad_sch]

Parts:
C501, C503, C505: 100nF; C_0603_1608Metric; Part number CC0603KRX7R9BB104; LCSC C14663
C502, C504, C506: 1uF; C_0603_1608Metric; Part number CL10A105KB8NNNC; LCSC C15849
J501: Wheel FPC 0.5mm; Jushuo_AFC07-S06FCA-00_1x6-1MP_P0.50_Horizontal; Part number AFC07-S06FCA-00; LCSC C262553
J502: Wheel header; PinHeader_1x06_P2.54mm_Vertical
JP501: MPR121 drain; SolderJumper-2_P1.3mm_Bridged_RoundedPad1.0x1.5mm
JP502: Haptic drain; SolderJumper-2_P1.3mm_Bridged_RoundedPad1.0x1.5mm
R501, R503, R504, R505, R506, R507, R508: 10k; R_0603_1608Metric; Part number 0603WAF1002T5E; LCSC C25804
R502: 75k; R_0603_1608Metric; Part number 0603WAF7502T5E; LCSC C23242
R509: 100k; R_0603_1608Metric; Part number 0603WAF1003T5E; LCSC C25803
SW501: SKQGAFE010 Center; SW_SKQGAFE010; Part number SKQGAFE010; LCSC C202424
SW502: SKQGAFE010 Top; SW_SKQGAFE010; Part number SKQGAFE010; LCSC C202424
SW503: SKQGAFE010 Right; SW_SKQGAFE010; Part number SKQGAFE010; LCSC C202424
SW504: SKQGAFE010 Bottom; SW_SKQGAFE010; Part number SKQGAFE010; LCSC C202424
SW505: SKQGAFE010 Left; SW_SKQGAFE010; Part number SKQGAFE010; LCSC C202424
SW506: OFF / HOLD / ON; SW_SP3T_PCM13; Part number PCM13SMTR; LCSC C221842
TP501: M+; TestPoint_Pad_1.5x1.5mm
TP502: M-; TestPoint_Pad_1.5x1.5mm
U501: MPR121QR2; mpr121qr2; Part number MPR121QR2; LCSC C91322
U502: DRV2605L; VSSOP-10_3x3mm_P0.5mm; Part number DRV2605LDGSR; LCSC C527464

Connections:
3V3_EN: SW506.1; also elsewhere on the board
+3.3V: JP501.1 (A), JP502.1 (A), R501.1, R503.1, R504.1, R505.1, R506.1, R507.1, R508.1; also elsewhere on the board
/Buttons/DRV_VDD: C504.1, C505.1, JP502.2 (B), U502.6 (VDD/NC), U502.10 (VDD)
/Buttons/MPR_VDD: C501.1, C502.1, JP501.2 (B), U501.4 (ADDR), U501.20 (VDD)
BTN_BOTTOM: R506.2, SW504.1, SW504.2; also elsewhere on the board
BTN_CENTER: R503.2, SW501.1, SW501.2; also elsewhere on the board
BTN_LEFT: R507.2, SW505.1, SW505.2; also elsewhere on the board
BTN_RIGHT: R505.2, SW503.1, SW503.2; also elsewhere on the board
BTN_TOP: R504.2, SW502.1, SW502.2; also elsewhere on the board
DRV_EN: R509.1, U502.5 (EN); also elsewhere on the board
GND: C501.2, C502.2, C503.2, C504.2, C505.2, C506.2, J501.5, J501.MP (MountPin), J502.5, R502.2, R509.2, SW501.3, SW501.4, SW502.3, SW502.4, SW503.3, SW503.4, SW504.3, SW504.4, SW505.3, SW505.4, SW506.3, U501.6 (VSS), U502.4 (IN/TRIG), U502.8 (GND); also elsewhere on the board
I2C1_SCL: U501.2 (SCL), U502.2 (SCL); also elsewhere on the board
I2C1_SDA: U501.3 (SDA), U502.3 (SDA); also elsewhere on the board
LOCK_SW: R508.2, SW506.2; also elsewhere on the board
MPR121_IRQ: R501.2, U501.1 (~IRQ); also elsewhere on the board
MPR_WHEEL_BOTTOM: U501.11 (ELEC3); also elsewhere on the board
MPR_WHEEL_CENTER: U501.12 (ELEC4); also elsewhere on the board
MPR_WHEEL_LEFT: U501.9 (ELEC1); also elsewhere on the board
MPR_WHEEL_RIGHT: U501.8 (ELEC0); also elsewhere on the board
MPR_WHEEL_TOP: U501.10 (ELEC2); also elsewhere on the board
unnamed: R502.1, U501.7 (REXT)
unnamed: C503.1, U501.5 (VREG)
unnamed: TP501.1 (1_1), U502.7 (OUT+)
unnamed: TP502.1 (1_1), U502.9 (OUT-)
unnamed: C506.1, U502.1 (REG)
WHEEL_BOTTOM: J501.3, J502.3; also elsewhere on the board
WHEEL_CENTER: J501.6, J502.6; also elsewhere on the board
WHEEL_LEFT: J501.4, J502.4; also elsewhere on the board
WHEEL_RIGHT: J501.2, J502.2; also elsewhere on the board
WHEEL_TOP: J501.1, J502.1; also elsewhere on the board

Notes on the sheet:
Power / hold slider, OFF - HOLD - ON: OFF pulls 3V3_EN low: TPS63802 off (so the MCU, and with it VS_EN: VS1053 LDOs off too). DRV2605L off too. Charger and gauge stay on the battery. HOLD pulls LOCK_SW (PE3) low. Going from ON to OFF passes HOLD: save state, finish SD writes there.
Haptics: DRV2605L, 10 mm coin ERM on M+/M- pads. +3.3V -> JP502 (cut to measure) -> DRV_VDD. I2C1 at 0x5A. EN = DRV_EN (PB5), R509 pull-down: shutdown while the MCU is off. IN/TRIG to GND (internal trigger).
MPR121
Click wheel buttons
Electrodes connections
Same core as the Adafruit MPR121 breakout (github.com/adafruit/Adafruit-MPR121-PCB): VREG 100n, REXT 75k, ~IRQ 10k pull-up. No regulator / level shifter: 3.3V only. ADDR on VDD: 0x5B. I2C1 pull-ups are on the MCU sheet. Electrodes: ELE0 right, ELE1 left, ELE2 top, ELE3 bottom (software/src/ClickWhe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
Click wheel electrodes: 0.5 mm FPC (J501) or 2.54 mm header (J502), wired in parallel: 1 top, 2 right, 3 bottom, 4 left, 5 GND, 6 center (pins 1-5 as the clickwheel symbol). Use one at a time: the unused one only adds a little stray capacitance. J501: Jushuo AFC07-S06FCA-00 (LCSC C262553), bottom c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
MPR121 on the always-on +3.3V (it shares I2C1, see the back-powering rules). JP501: cut to measure its drain.
ON/OFF Hold
Click-wheel buttons, soldered on this board under the wheel. Active low, 10k pull-ups (as the click-wheel devboard). BTN_* on PE11-PE15 (EXTI11-15).
Power
