Leo-Nicolle/opentone/hardware/opentone/opentone.kicad_pcb

## KiCad design hardware/opentone/opentone.kicad_pcb (continued)

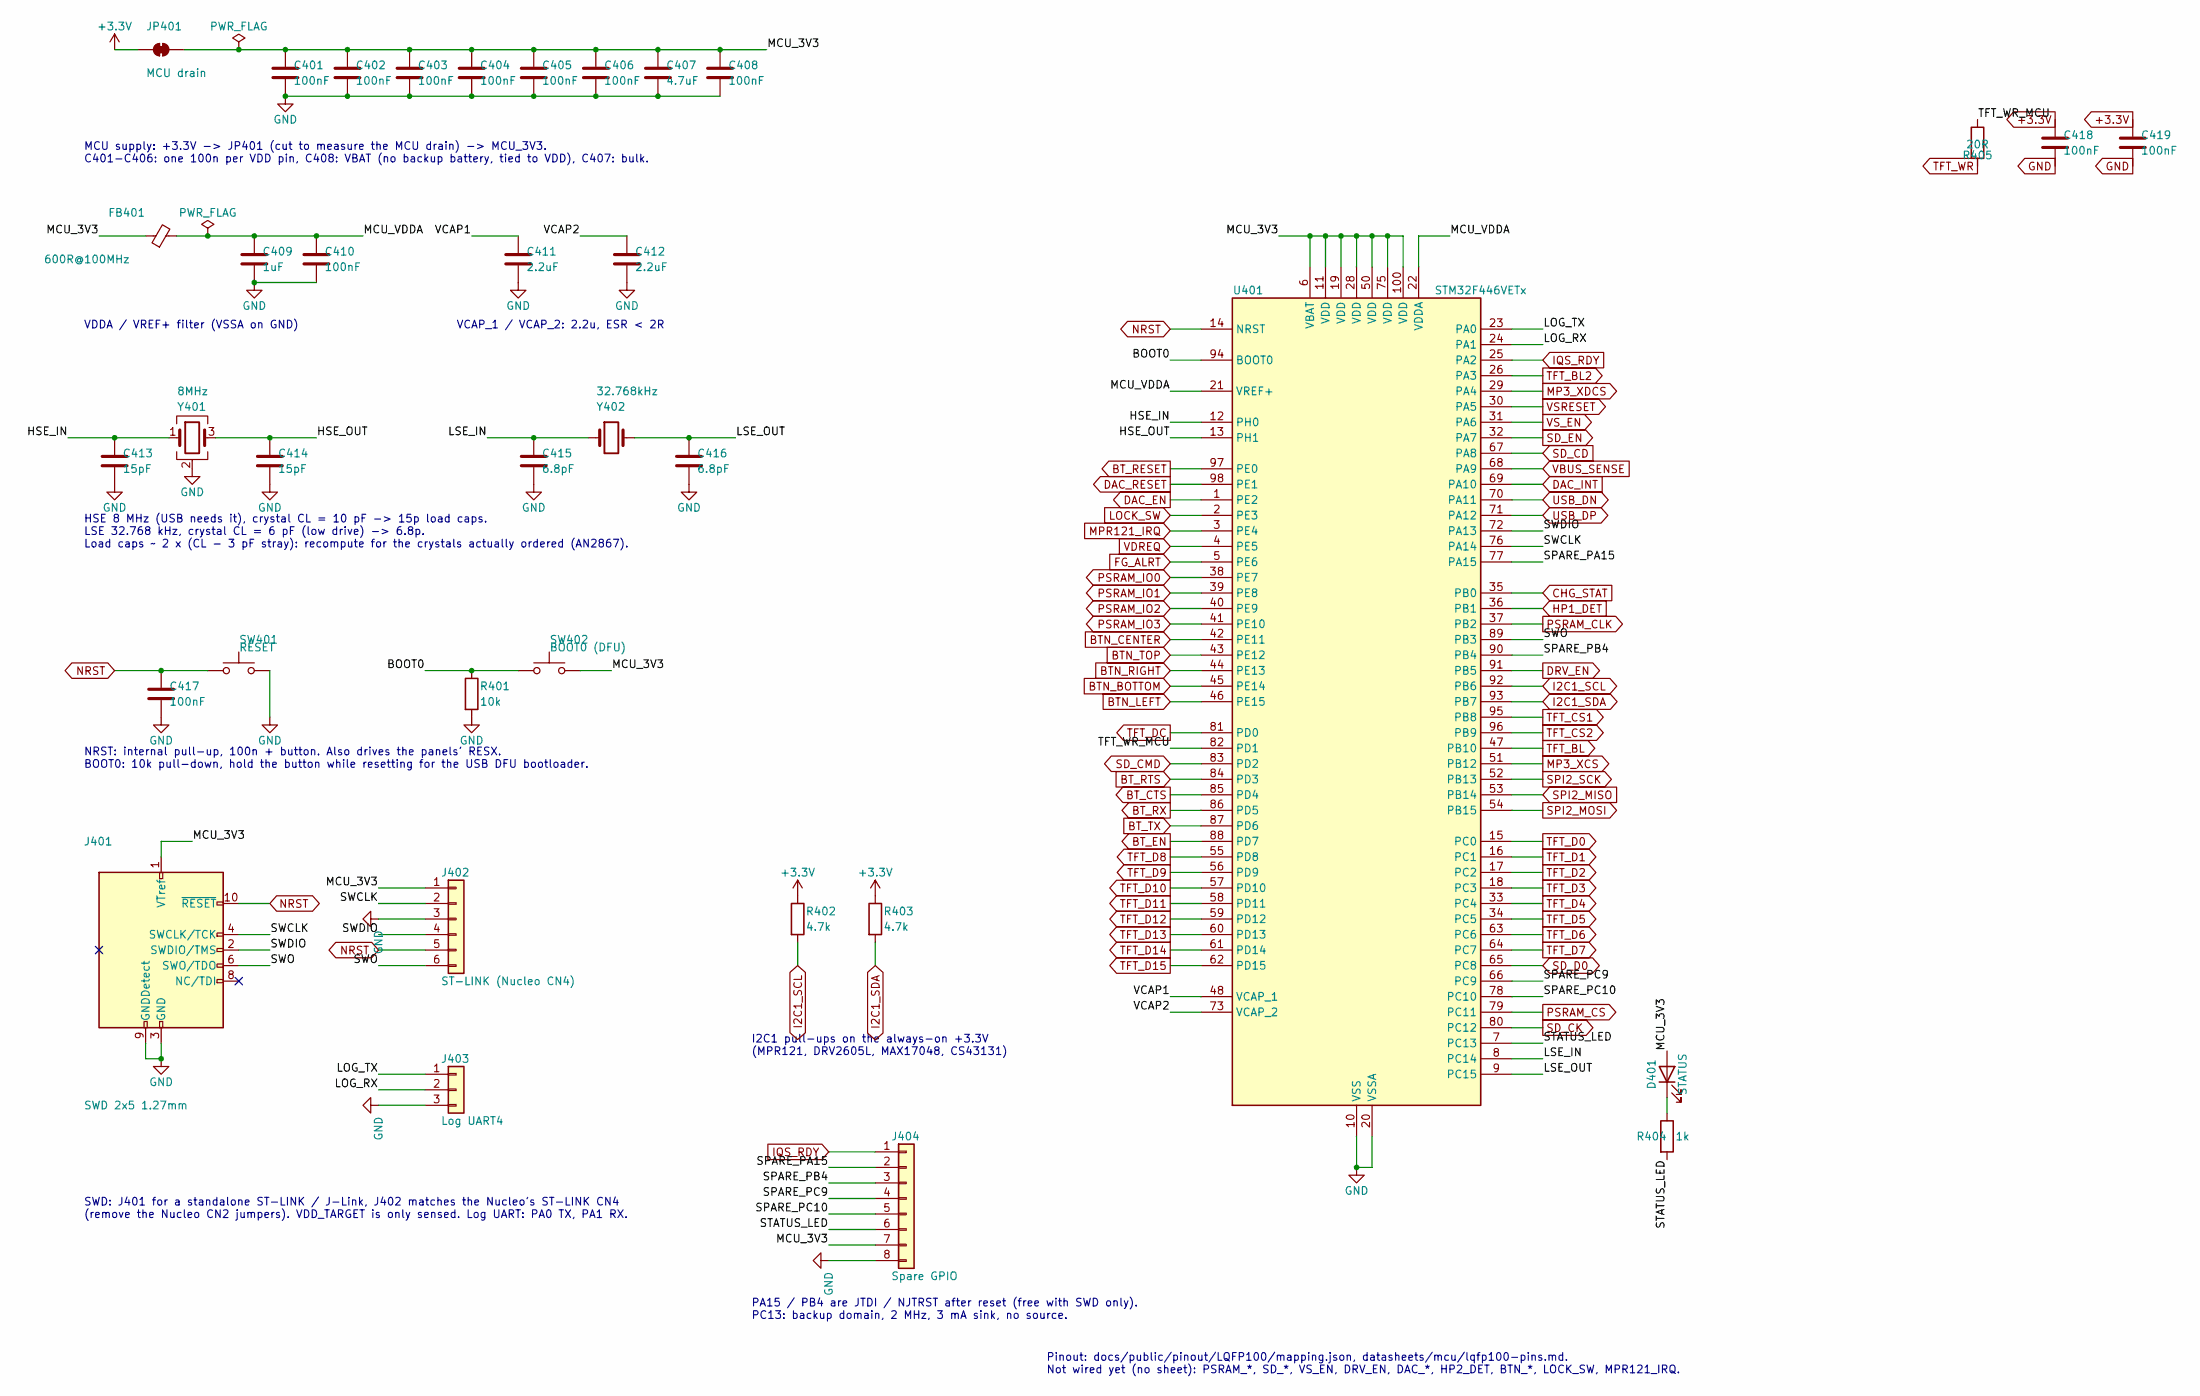
[picture p7: schematic mcu.kicad_sch]

Parts:
C401, C402, C403, C404, C405, C406, C408, C410, C417, C418, C419: 100nF; C_0603_1608Metric; Part number CC0603KRX7R9BB104; LCSC C14663
C407: 4.7uF; C_0603_1608Metric; Part number CL10A475KO8NNNC; LCSC C19666
C409: 1uF; C_0603_1608Metric; Part number CL10A105KB8NNNC; LCSC C15849
C411, C412: 2.2uF; C_0603_1608Metric; Part number CL10A225KO8NNNC; LCSC C23630
C413, C414: 15pF; C_0603_1608Metric; Part number CL10C150JB8NNNC; LCSC C1644
C415, C416: 6.8pF; C_0603_1608Metric; Part number 0603CG6R8C500NT; LCSC C1679
D401: STATUS; LED_0603_1608Metric; Part number KT-0603R; LCSC C2286
FB401: 600R@100MHz; L_0603_1608Metric; Part number GZ1608D601TF; LCSC C1002
J401: SWD 2x5 1.27mm; PinHeader_2x05_P1.27mm_Vertical_SMD; Part number 20021121-00010C4LF; LCSC C150517
J402: ST-LINK (Nucleo CN4); PinHeader_1x06_P2.54mm_Vertical
J403: Log UART4; PinHeader_1x03_P2.54mm_Vertical
J404: Spare GPIO; PinHeader_1x08_P2.54mm_Vertical
JP401: MCU drain; SolderJumper-2_P1.3mm_Bridged_RoundedPad1.0x1.5mm
R401: 10k; R_0603_1608Metric; Part number 0603WAF1002T5E; LCSC C25804
R402, R403: 4.7k; R_0603_1608Metric; Part number 0603WAF4701T5E; LCSC C23162
R404: 1k; R_0603_1608Metric; Part number 0603WAF1001T5E; LCSC C21190
R405: 20R; R_0603_1608Metric; Part number 0603WAF200JT5E; LCSC C22950
SW401: RESET; SW_SPST_PTS810; Part number PTS810SJG250SMTRLFS; LCSC C221895
SW402: BOOT0 (DFU); SW_SPST_PTS810; Part number PTS810SJG250SMTRLFS; LCSC C221895
U401: STM32F446VETx; LQFP-100_14x14mm_P0.5mm; Part number STM32F446VET6; LCSC C91929
Y401: 8MHz; Crystal_SMD_3225-4Pin_3.2x2.5mm; Part number K3A080001010; LCSC C19076848
Y402: 32.768kHz; Crystal_SMD_3215-2Pin_3.2x1.5mm; Part number FC-135 32.7680KA-E; LCSC C20340322

Connections:
+3.3V: C418.1, C419.1, JP401.1 (A), R402.1, R403.1; also elsewhere on the board
/MCU/BOOT0: R401.1, SW402.1, U401.94 (BOOT0)
/MCU/HSE_IN: C413.1, U401.12 (PH0), Y401.1
/MCU/HSE_OUT: C414.1, U401.13 (PH1), Y401.3
/MCU/LOG_RX: J403.2, U401.24 (PA1)
/MCU/LOG_TX: J403.1, U401.23 (PA0)
/MCU/LSE_IN: C415.1, U401.8 (PC14), Y402.1
/MCU/LSE_OUT: C416.1, U401.9 (PC15), Y402.2
/MCU/MCU_3V3: C401.1, C402.1, C403.1, C404.1, C405.1, C406.1, C407.1, C408.1, D401.2 (A), FB401.1, J401.1 (VTref), J402.1, J404.7, JP401.2 (B), SW402.2, U401.6 (VBAT), U401.11 (VDD), U401.19 (VDD), U401.28 (VDD), U401.50 (VDD), U401.75 (VDD), U401.100 (VDD)
/MCU/MCU_VDDA: C409.1, C410.1, FB401.2, U401.21 (VREF+), U401.22 (VDDA)
/MCU/SPARE_PA15: J404.2, U401.77 (PA15)
/MCU/SPARE_PB4: J404.3, U401.90 (PB4)
/MCU/SPARE_PC9: J404.4, U401.66 (PC9)
/MCU/SPARE_PC10: J404.5, U401.78 (PC10)
/MCU/STATUS_LED: J404.6, R404.2, U401.7 (PC13)
/MCU/SWCLK: J401.4 (SWCLK/TCK), J402.2, U401.76 (PA14)
/MCU/SWDIO: J401.2 (SWDIO/TMS), J402.4, U401.72 (PA13)
/MCU/SWO: J401.6 (SWO/TDO), J402.6, U401.89 (PB3)
/MCU/TFT_WR_MCU: R405.1, U401.82 (PD1)
/MCU/VCAP1: C411.1, U401.48 (VCAP_1)
/MCU/VCAP2: C412.1, U401.73 (VCAP_2)
BTN_BOTTOM: U401.45 (PE14); also elsewhere on the board
BTN_CENTER: U401.42 (PE11); also elsewhere on the board
BTN_LEFT: U401.46 (PE15); also elsewhere on the board
BTN_RIGHT: U401.44 (PE13); also elsewhere on the board
BTN_TOP: U401.43 (PE12); also elsewhere on the board
BT_CTS: U401.85 (PD4); also elsewhere on the board
BT_EN: U401.88 (PD7); also elsewhere on the board
BT_RESET: U401.97 (PE0); also elsewhere on the board
BT_RTS: U401.84 (PD3); also elsewhere on the board
BT_RX: U401.86 (PD5); also elsewhere on the board
BT_TX: U401.87 (PD6); also elsewhere on the board
CHG_STAT: U401.35 (PB0); also elsewhere on the board
DAC_EN: U401.1 (PE2); also elsewhere on the board
DAC_INT: U401.69 (PA10); also elsewhere on the board
DAC_RESET: U401.98 (PE1); also elsewhere on the board
DRV_EN: U401.91 (PB5); also elsewhere on the board
FG_ALRT: U401.5 (PE6); also elsewhere on the board
GND: C401.2, C402.2, C403.2, C404.2, C405.2, C406.2, C407.2, C408.2, C409.2, C410.2, C411.2, C412.2, C413.2, C414.2, C415.2, C416.2, C417.2, C418.2, C419.2, J401.3 (GND), J401.5 (GND), J401.9 (GNDDetect), J402.3, J403.3, J404.8, R401.2, SW401.2, U401.10 (VSS), U401.20 (VSSA), U401.27 (VSS), U401.49 (VSS), U401.74 (VSS), U401.99 (VSS), Y401.2 (G), Y401.4 (G); also elsewhere on the board
HP1_DET: U401.36 (PB1); also elsewhere on the board
I2C1_SCL: R402.2, U401.92 (PB6); also elsewhere on the board
I2C1_SDA: R403.2, U401.93 (PB7); also elsewhere on the board
IQS_RDY: J404.1, U401.25 (PA2); also elsewhere on the board
LOCK_SW: U401.2 (PE3); also elsewhere on the board
MP3_XCS: U401.51 (PB12); also elsewhere on the board
MP3_XDCS: U401.29 (PA4); also elsewhere on the board
MPR121_IRQ: U401.3 (PE4); also elsewhere on the board
NRST: C417.1, J401.10 (~RESET), J402.5, SW401.1, U401.14 (NRST); also elsewhere on the board
unnamed: D401.1 (K), R404.1
PSRAM_CLK: U401.37 (PB2); also elsewhere on the board
PSRAM_CS: U401.79 (PC11); also elsewhere on the board
PSRAM_IO0: U401.38 (PE7); also elsewhere on the board
PSRAM_IO1: U401.39 (PE8); also elsewhere on the board
PSRAM_IO2: U401.40 (PE9); also elsewhere on the board
PSRAM_IO3: U401.41 (PE10); also elsewhere on the board
SD_CD: U401.67 (PA8); also elsewhere on the board
SD_CK: U401.80 (PC12); also elsewhere on the board
SD_CMD: U401.83 (PD2); also elsewhere on the board
SD_D0: U401.65 (PC8); also elsewhere on the board
SD_EN: U401.32 (PA7); also elsewhere on the board
SPI2_MISO: U401.53 (PB14); also elsewhere on the board
SPI2_MOSI: U401.54 (PB15); also elsewhere on the board
SPI2_SCK: U401.52 (PB13); also elsewhere on the board
TFT_BL: U401.47 (PB10); also elsewhere on the board
TFT_BL2: U401.26 (PA3); also elsewhere on the board
TFT_CS1: U401.95 (PB8); also elsewhere on the board
TFT_CS2: U401.96 (PB9); also elsewhere on the board
TFT_D0: U401.15 (PC0); also elsewhere on the board
TFT_D1: U401.16 (PC1); also elsewhere on the board
TFT_D2: U401.17 (PC2); also elsewhere on the board
TFT_D3: U401.18 (PC3); also elsewhere on the board
TFT_D4: U401.33 (PC4); also elsewhere on the board
TFT_D5: U401.34 (PC5); also elsewhere on the board
TFT_D6: U401.63 (PC6); also elsewhere on the board
TFT_D7: U401.64 (PC7); also elsewhere on the board
TFT_D8: U401.55 (PD8); also elsewhere on the board
TFT_D9: U401.56 (PD9); also elsewhere on the board
TFT_D10: U401.57 (PD10); also elsewhere on the board
TFT_D11: U401.58 (PD11); also elsewhere on the board
TFT_D12: U401.59 (PD12); also elsewhere on the board
TFT_D13: U401.60 (PD13); also elsewhere on the board
TFT_D14: U401.61 (PD14); also elsewhere on the board
TFT_D15: U401.62 (PD15); also elsewhere on the board
TFT_DC: U401.81 (PD0); also elsewhere on the board
TFT_WR: R405.2; also elsewhere on the board
USB_DN: U401.70 (PA11); also elsewhere on the board
USB_DP: U401.71 (PA12); also elsewhere on the board
VBUS_SENSE: U401.68 (PA9); also elsewhere on the board
VDREQ: U401.4 (PE5); also elsewhere on the board
VSRESET: U401.30 (PA5); also elsewhere on the board
VS_EN: U401.31 (PA6); also elsewhere on the board

Notes on the sheet:
Pinout: docs/public/pinout/LQFP100/mapping.json, datasheets/mcu/lqfp100-pins.md. Not wired yet (no sheet): PSRAM_*, SD_*, VS_EN, DRV_EN, DAC_*, HP2_DET, BTN_*, LOCK_SW, MPR121_IRQ.
I2C1 pull-ups on the always-on +3.3V (MPR121, DRV2605L, MAX17048, CS43131)
VDDA / VREF+ filter (VSSA on GND)
MCU supply: +3.3V -> JP401 (cut to measure the MCU drain) -> MCU_3V3. C401-C406: one 100n per VDD pin, C408: VBAT (no backup battery, tied to VDD), C407: bulk.
PA15 / PB4 are JTDI / NJTRST after reset (free with SWD only). PC13: backup domain, 2 MHz, 3 mA sink, no source.
NRST: internal pull-up, 100n + button. Also drives the panels' RESX. BOOT0: 10k pull-down, hold the button while resetting for the USB DFU bootloader.
HSE 8 MHz (USB needs it), crystal CL = 10 pF -> 15p load caps. LSE 32.768 kHz, crystal CL = 6 pF (low drive) -> 6.8p. Load caps ~ 2 x (CL - 3 pF stray): recompute for the crystals actually ordered (AN2867).
VCAP_1 / VCAP_2: 2.2u, ESR < 2R
SWD: J401 for a standalone ST-LINK / J-Link, J402 matches the Nucleo's ST-LINK CN4 (remove the Nucleo CN2 jumpers). VDD_TARGET is only sensed. Log UART: PA0 TX, PA1 RX.

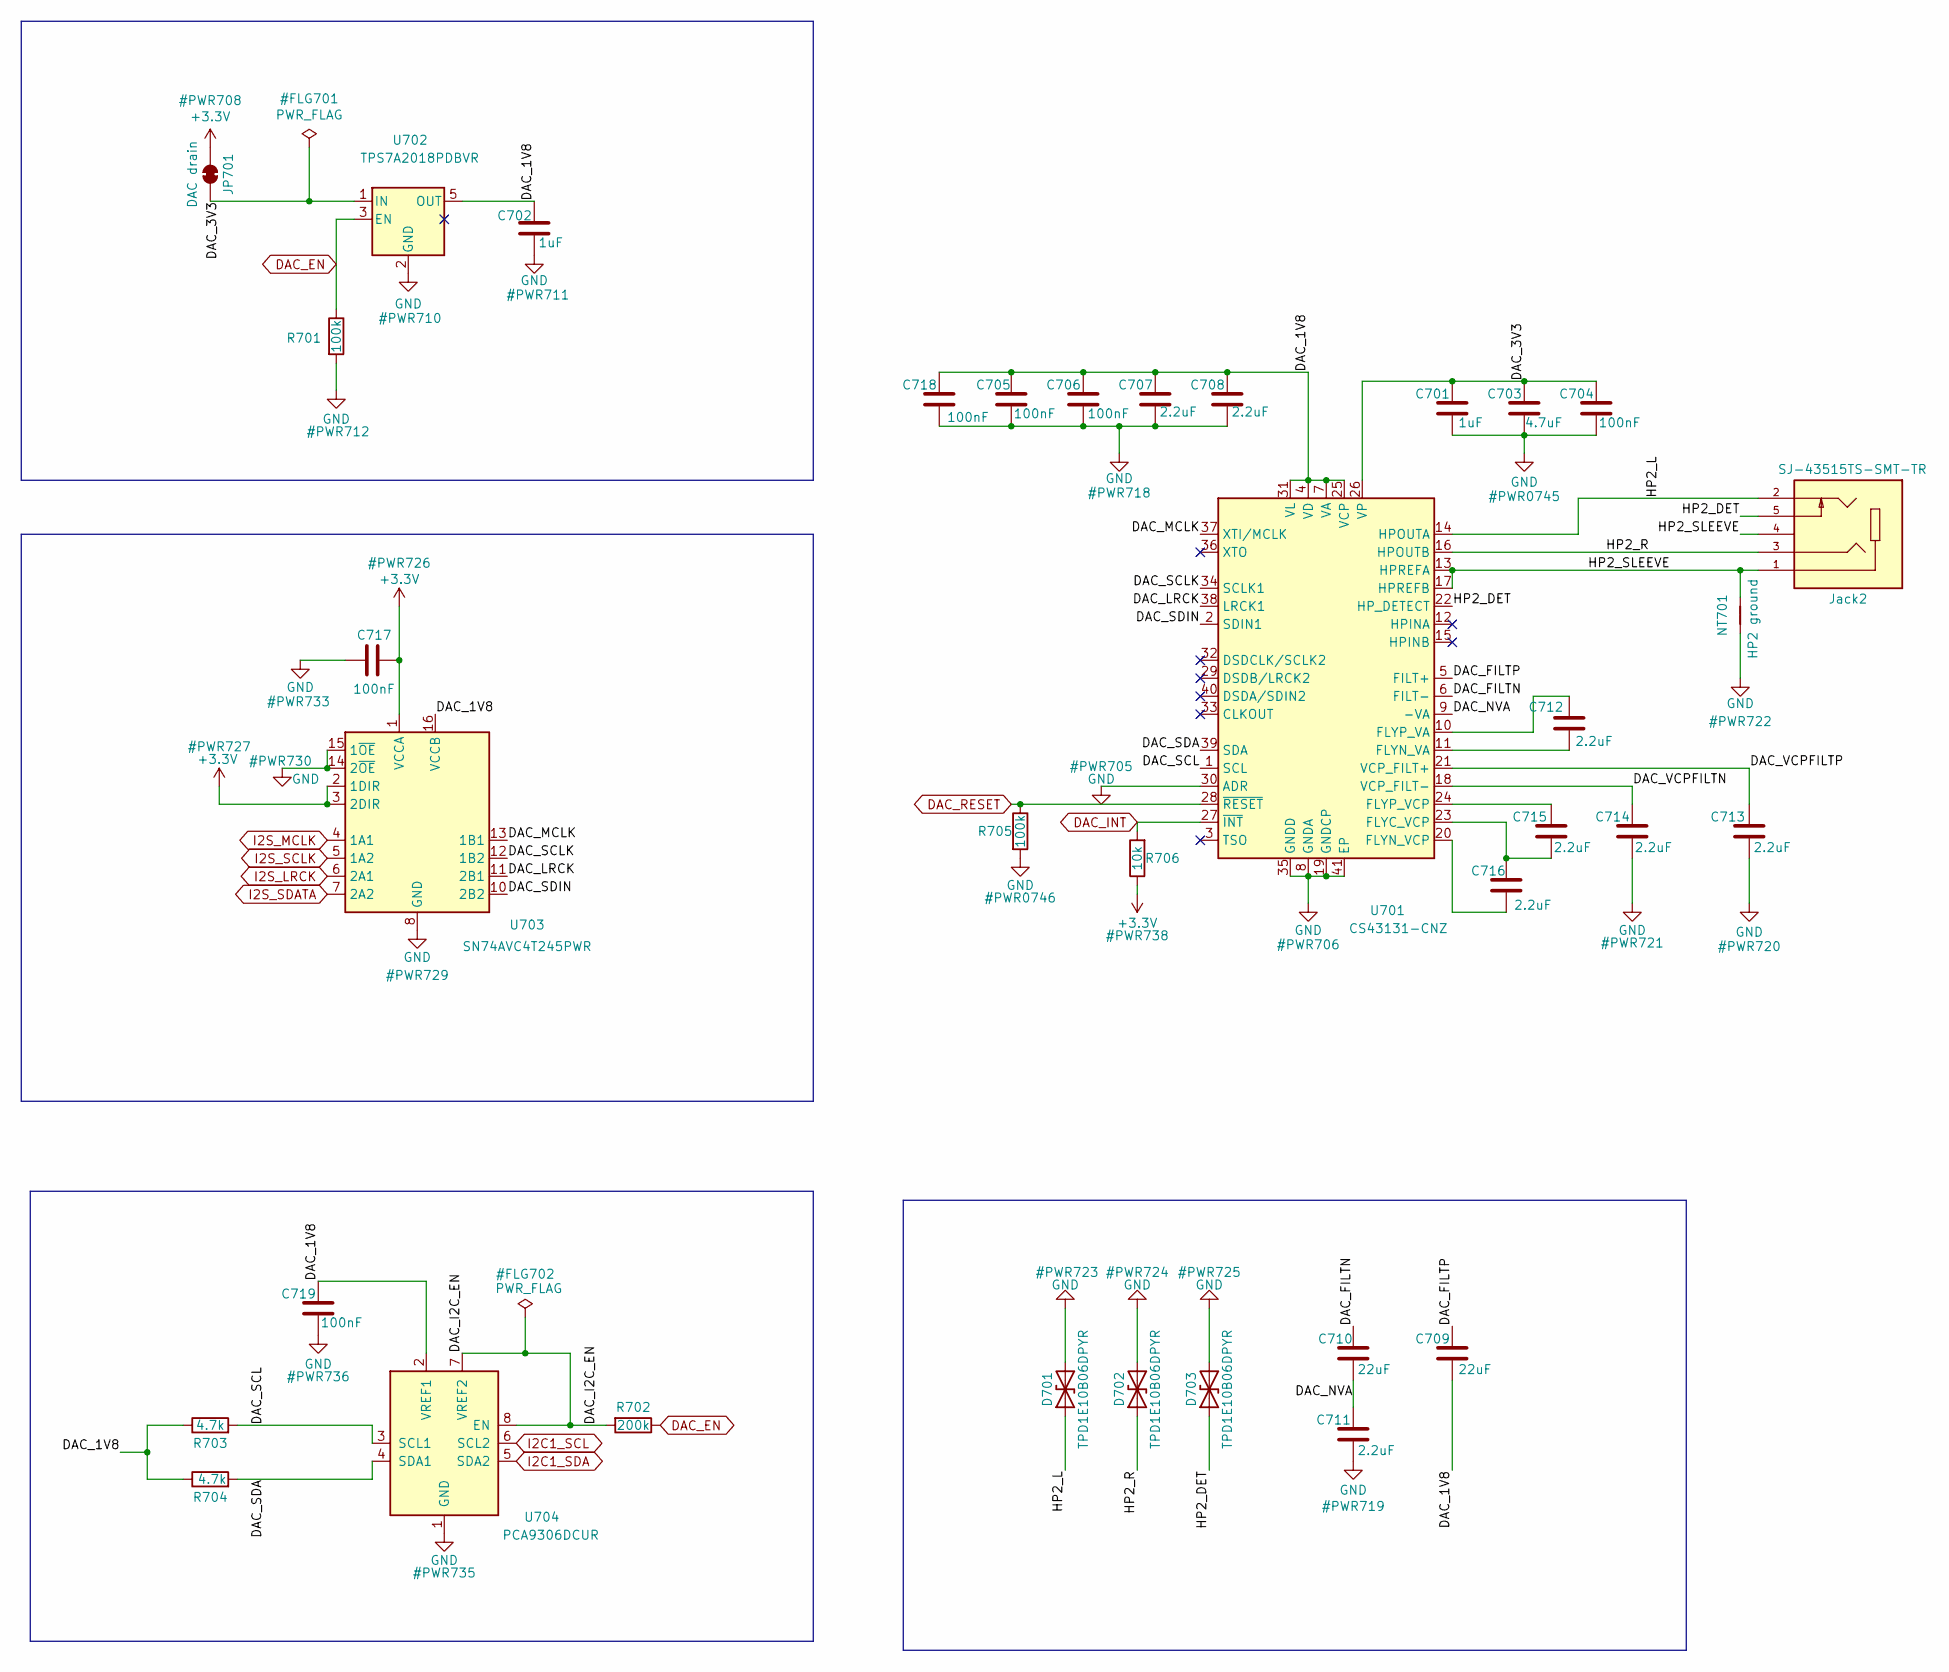
[picture p8: schematic dac.kicad_sch]

Parts:
C701, C702: 1uF; C_0603_1608Metric; Part number CL10A105KB8NNNC; LCSC C15849
C703: 4.7uF; C_0603_1608Metric; Part number CL10A475KO8NNNC; LCSC C19666
C704, C705, C706, C717, C718, C719: 100nF; C_0603_1608Metric; Part number CC0603KRX7R9BB104; LCSC C14663
C707, C708, C711, C712, C713, C714, C715, C716: 2.2uF; C_0603_1608Metric; Part number CL10A225KO8NNNC; LCSC C23630
C709, C710: 22uF; C_0805_2012Metric; Part number CL21A226MAQNNNE; LCSC C45783
D701, D702, D703: TPD1E10B06DPYR; Texas_DPY0002A_0.6x1mm_P0.65mm; Part number TPD1E10B06DPYR; LCSC C48260
JP701: DAC drain; SolderJumper-2_P1.3mm_Bridged_RoundedPad1.0x1.5mm
Jack2: SJ-43515TS-SMT-TR; CUI_SJ-43515TS-SMT-TR; Part number SJ-43515TS-SMT-TR; LCSC C5353507
NT701: HP2 ground; NetTie-2_SMD_Pad0.5mm
R701, R705: 100k; R_0603_1608Metric; Part number 0603WAF1003T5E; LCSC C25803
R702: 200k; R_0603_1608Metric; Part number 0603WAF2003T5E; LCSC C25811
R703, R704: 4.7k; R_0603_1608Metric; Part number 0603WAF4701T5E; LCSC C23162
R706: 10k; R_0603_1608Metric; Part number 0603WAF1002T5E; LCSC C25804
U701: CS43131-CNZ; TQFN-40-1EP_5x5mm_P0.4mm_EP3.5x3.5mm; Part number CS43131-CNZ; LCSC C1554759
U702: TPS7A2018PDBVR; SOT-23-5; Part number TPS7A2018PDBVR; LCSC C963430
U703: SN74AVC4T245PWR; TSSOP-16_4.4x5mm_P0.65mm; Part number SN74AVC4T245PWR; LCSC C81461
U704: PCA9306DCUR; VSSOP-8_2.3x2mm_P0.5mm; Part number PCA9306DCUR; LCSC C33196

Connections:
+3.3V: C717.1, JP701.1 (A), R706.1, U703.1 (VCCA), U703.2 (1DIR), U703.3 (2DIR); also elsewhere on the board
/DAC/DAC_1V8: C702.1, C705.1, C706.1, C707.1, C708.1, C709.2, C718.1, C719.1, R703.1, R704.1, U701.4 (VD), U701.7 (VA), U701.25 (VCP), U701.31 (VL), U702.5 (OUT), U703.16 (VCCB), U704.2 (VREF1)
/DAC/DAC_3V3: C701.1, C703.1, C704.1, JP701.2 (B), U701.26 (VP), U702.1 (IN)
/DAC/DAC_FILTN: C710.1, U701.6 (FILT-)
/DAC/DAC_FILTP: C709.1, U701.5 (FILT+)
/DAC/DAC_I2C_EN: R702.2, U704.7 (VREF2), U704.8 (EN)
/DAC/DAC_LRCK: U701.38 (LRCK1), U703.11 (2B1)
/DAC/DAC_MCLK: U701.37 (XTI/MCLK), U703.13 (1B1)
/DAC/DAC_NVA: C710.2, C711.1, U701.9 (-VA)
/DAC/DAC_SCL: R703.2, U701.1 (SCL), U704.3 (SCL1)
/DAC/DAC_SCLK: U701.34 (SCLK1), U703.12 (1B2)
/DAC/DAC_SDA: R704.2, U701.39 (SDA), U704.4 (SDA1)
/DAC/DAC_SDIN: U701.2 (SDIN1), U703.10 (2B2)
/DAC/DAC_VCPFILTN: C714.1, U701.18 (VCP_FILT-)
/DAC/DAC_VCPFILTP: C713.1, U701.21 (VCP_FILT+)
/DAC/HP2_DET: D703.1 (A1), Jack2.5, U701.22 (HP_DETECT)
/DAC/HP2_L: D701.1 (A1), Jack2.2, U701.14 (HPOUTA)
/DAC/HP2_R: D702.1 (A1), Jack2.3, U701.16 (HPOUTB)
/DAC/HP2_SLEEVE: Jack2.1, Jack2.4, NT701.2, U701.13 (HPREFA), U701.17 (HPREFB)
DAC_EN: R701.1, R702.1, U702.3 (EN); also elsewhere on the board
DAC_INT: R706.2, U701.27 (~INT); also elsewhere on the board
DAC_RESET: R705.1, U701.28 (~RESET); also elsewhere on the board
GND: C701.2, C702.2, C703.2, C704.2, C705.2, C706.2, C707.2, C708.2, C711.2, C713.2, C714.2, C717.2, C718.2, C719.2, D701.2 (A2), D702.2 (A2), D703.2 (A2), NT701.1, R701.2, R705.2, U701.8 (GNDA), U701.19 (GNDCP), U701.30 (ADR), U701.35 (GNDD), U701.41 (EP), U702.2 (GND), U703.8 (GND), U703.9 (GND), U703.14 (2~OE), U703.15 (1~OE), U704.1 (GND); also elsewhere on the board
I2C1_SCL: U704.6 (SCL2); also elsewhere on the board
I2C1_SDA: U704.5 (SDA2); also elsewhere on the board
I2S_LRCK: U703.6 (2A1); also elsewhere on the board
I2S_MCLK: U703.4 (1A1); also elsewhere on the board
I2S_SCLK: U703.5 (1A2); also elsewhere on the board
I2S_SDATA: U703.7 (2A2); also elsewhere on the board
unnamed: C715.2, C716.1, U701.23 (FLYC_VCP)
unnamed: C712.2, U701.11 (FLYN_VA)
unnamed: C716.2, U701.20 (FLYN_VCP)
unnamed: C712.1, U701.10 (FLYP_VA)
unnamed: C715.1, U701.24 (FLYP_VCP)

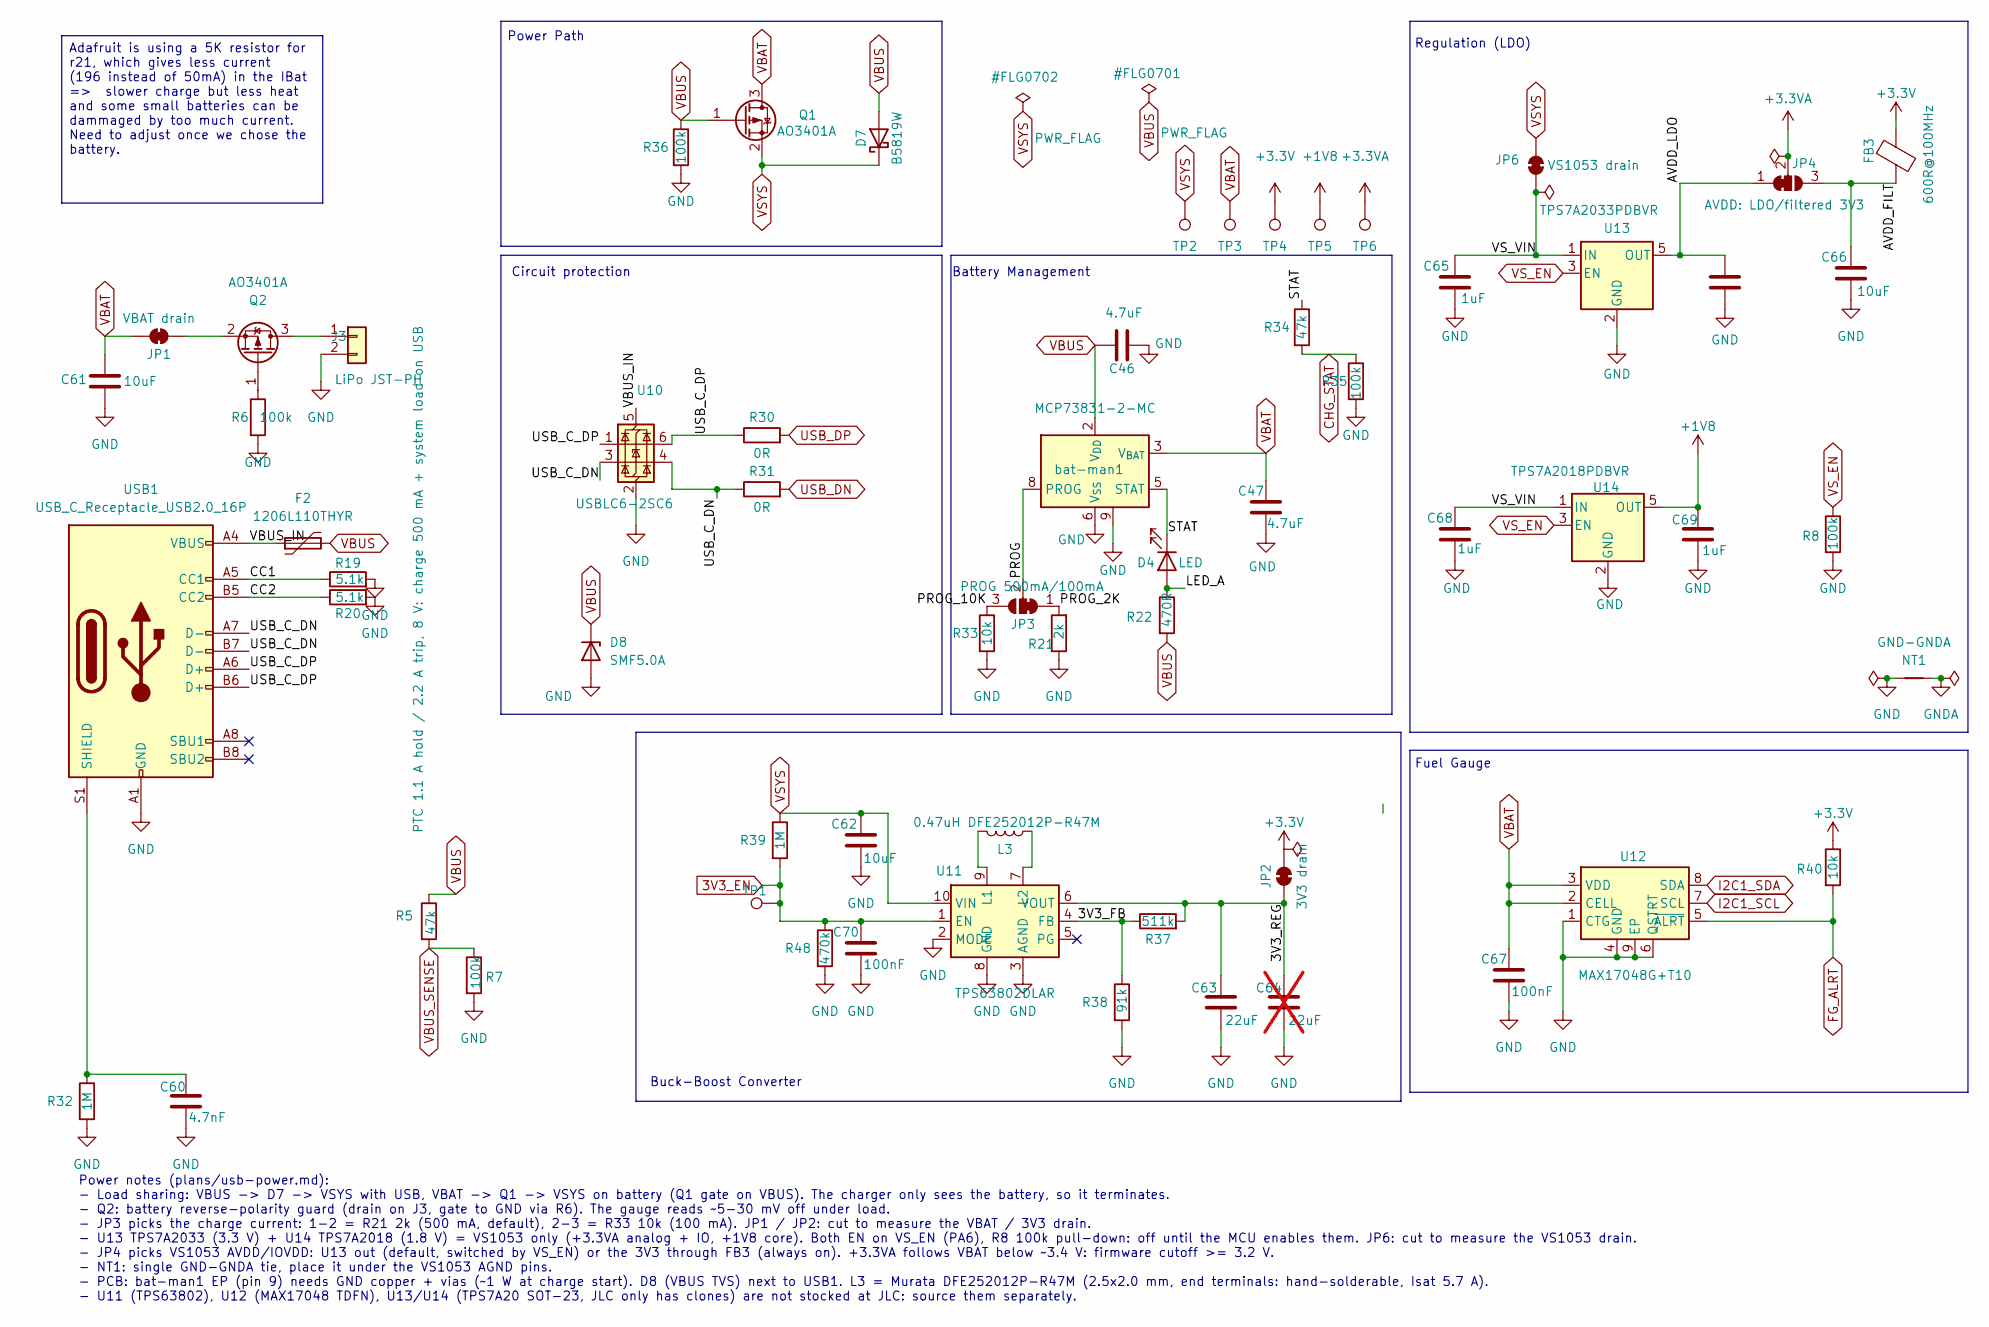
[picture p9: schematic power.kicad_sch]

Parts:
C46, C47: 4.7uF; C_0805_2012Metric; Part number CL21A475KAQNNNE; LCSC C1779
C52, C65, C68, C69: 1uF; C_0603_1608Metric; Part number CL10A105KB8NNNC; LCSC C15849
C60: 4.7nF; C_0603_1608Metric; Part number 0603B472K500NT; LCSC C53987
C61, C62: 10uF; C_0805_2012Metric; Part number CL21A106KAYNNNE; LCSC C15850
C63: 22uF; C_0805_2012Metric; Part number CL21A226MAQNNNE; LCSC C45783
C64: 22uF; C_0805_2012Metric; Part number CL21A226MAQNNNE; LCSC C45783; not fitted
C66: 10uF; C_0603_1608Metric; Part number CL10A106KP8NNNC; LCSC C19702
C67, C70: 100nF; C_0603_1608Metric; Part number CC0603KRX7R9BB104; LCSC C14663
D4: LED; LED_0603_1608Metric; Part number KT-0603R; LCSC C2286
D7: B5819W; D_SOD-123; Part number B5819W SL; LCSC C8598
D8: SMF5.0A; D_SOD-123F; Part number SMF5.0A; LCSC C151296
F2: 1206L110THYR; Fuse_1206_3216Metric; Part number 1206L110THYR; LCSC C126818
FB3: 600R@100MHz; L_0603_1608Metric; Part number GZ1608D601TF; LCSC C1002
J3: LiPo JST-PH; JST_PH_S2B-PH-SM4-TB_1x02-1MP_P2.00mm_Horizontal; Part number S2B-PH-SM4-TB(LF)(SN); LCSC C295747
JP1: VBAT drain; SolderJumper-2_P1.3mm_Bridged_RoundedPad1.0x1.5mm
JP2: 3V3 drain; SolderJumper-2_P1.3mm_Bridged_RoundedPad1.0x1.5mm
JP3: PROG 500mA/100mA; SolderJumper-3_P1.3mm_Bridged12_RoundedPad1.0x1.5mm
JP4: AVDD: LDO/filtered 3V3; SolderJumper-3_P1.3mm_Bridged12_RoundedPad1.0x1.5mm
JP6: VS1053 drain; SolderJumper-2_P1.3mm_Bridged_RoundedPad1.0x1.5mm
L3: 0.47uH DFE252012P-R47M; L_1008_2520Metric_Pad1.43x2.20mm_HandSolder; Part number DFE252012P-R47M=P2; LCSC C237552
NT1: GND-GNDA; NetTie-2_SMD_Pad0.5mm
Q1, Q2: AO3401A; SOT-23; Part number AO3401A; LCSC C15127
R5, R34: 47k; R_0603_1608Metric; Part number 0603WAF4702T5E; LCSC C25819
R6, R7, R8, R35, R36: 100k; R_0603_1608Metric; Part number 0603WAF1003T5E; LCSC C25803
R19, R20: 5.1k; R_0603_1608Metric; Part number 0603WAF5101T5E; LCSC C23186
R21: 2k; R_0603_1608Metric; Part number 0603WAF2001T5E; LCSC C22975
R22: 470R; R_0603_1608Metric; Part number 0603WAF4700T5E; LCSC C23179
R30, R31: 0R; R_0603_1608Metric; Part number 0603WAF0000T5E; LCSC C21189
R32, R39: 1M; R_0603_1608Metric; Part number 0603WAF1004T5E; LCSC C22935
R33, R40: 10k; R_0603_1608Metric; Part number 0603WAF1002T5E; LCSC C25804
R37: 511k; R_0603_1608Metric; Part number 0603WAF5113T5E; LCSC C23194
R38: 91k; R_0603_1608Metric; Part number 0603WAF9102T5E; LCSC C23265
R48: 470k; R_0603_1608Metric; Part number 0603WAF4703T5E; LCSC C23178
TP1: 3V3_EN; TestPoint_Pad_D1.0mm
TP2: VSYS; TestPoint_Pad_D1.0mm
TP3: VBAT; TestPoint_Pad_D1.0mm
TP4: +3.3V; TestPoint_Pad_D1.0mm
TP5: +1V8; TestPoint_Pad_D1.0mm
TP6: +3.3VA; TestPoint_Pad_D1.0mm
U10: USBLC6-2SC6; SOT-23-6; Part number USBLC6-2SC6; LCSC C7519
U11: TPS63802DLAR; Texas_DLA0010A_VSON-HR-10_2x3mm_P0.5mm; Part number TPS63802DLAR; LCSC C2845237
U12: MAX17048G+T10; TDFN-8-1EP_2x2mm_P0.5mm_EP0.8x1.2mm; Part number MAX17048G+T10; LCSC C2682616
U13: TPS7A2033PDBVR; SOT-23-5; Part number TPS7A2033PDBVR; LCSC C2862740
U14: TPS7A2018PDBVR; SOT-23-5; Part number TPS7A2018PDBVR; LCSC C963430
USB1: USB_C_Receptacle_USB2.0_16P; USB_C_Receptacle_HRO_TYPE-C-31-M-12; Part number TYPE-C-31-M-12; LCSC C165948
bat-man1: MCP73831-2-MC; DFN-8-1EP_3x2mm_P0.5mm_EP1.7x1.4mm; Part number MCP73831-2ACI/MC; LCSC C150772

Connections:
3V3_EN: C70.1, R39.2, R48.1, TP1.1 (1_1), U11.1 (EN); also elsewhere on the board
+1V8: C69.1, TP5.1 (1_1), U14.5 (OUT); also elsewhere on the board
+3.3V: FB3.1, JP2.2 (B), R40.1, TP4.1 (1_1); also elsewhere on the board
+3.3VA: JP4.2 (C), TP6.1 (1_1); also elsewhere on the board
/Power/3V3_FB: R37.1, R38.1, U11.4 (FB)
/Power/3V3_REG: C63.1, C64.1, JP2.1 (A), R37.2, U11.6 (VOUT)
/Power/AVDD_FILT: C66.1, FB3.2, JP4.3 (B)
/Power/AVDD_LDO: C52.1, JP4.1 (A), U13.5 (OUT)
/Power/CC1: R19.1, USB1.A5 (CC1)
/Power/CC2: R20.1, USB1.B5 (CC2)
/Power/LED_A: D4.2 (A), R22.1
/Power/PROG: JP3.2 (C), bat-man1.8 (PROG)
/Power/PROG_2K: JP3.1 (A), R21.2
/Power/PROG_10K: JP3.3 (B), R33.1
/Power/STAT: D4.1 (K), R34.1, bat-man1.5 (STAT)
/Power/USB_C_DN: R31.1, U10.3 (I/O2), U10.4 (I/O2), USB1.A7 (D-), USB1.B7 (D-)
/Power/USB_C_DP: R30.1, U10.1 (I/O1), U10.6 (I/O1), USB1.A6 (D+), USB1.B6 (D+)
/Power/VBUS_IN: F2.1, U10.5 (VBUS), USB1.A4 (VBUS), USB1.A9 (VBUS), USB1.B4 (VBUS), USB1.B9 (VBUS)
/Power/VS_VIN: C65.1, C68.1, JP6.2 (B), U13.1 (IN), U14.1 (IN)
CHG_STAT: R34.2, R35.1; also elsewhere on the board
FG_ALRT: R40.2, U12.5 (~ALRT); also elsewhere on the board
GND: C46.1, C47.2, C52.2, C60.2, C61.2, C62.2, C63.2, C64.2, C65.2, C66.2, C67.2, C68.2, C69.2, C70.2, D8.2 (A), J3.2, NT1.1, R6.2, R7.2, R8.2, R19.2, R20.2, R21.1, R32.2, R33.2, R35.2, R36.2, R38.2, R48.2, U10.2 (GND), U11.2 (MODE), U11.3 (AGND), U11.8 (GND), U12.1 (CTG), U12.4 (GND), U12.6 (QSTRT), U12.9 (EP), U13.2 (GND), U14.2 (GND), USB1.A1 (GND), USB1.A12 (GND), USB1.B1 (GND), USB1.B12 (GND), bat-man1.6 (V_{SS}), bat-man1.9; also elsewhere on the board
GNDA: NT1.2; also elsewhere on the board
I2C1_SCL: U12.7 (SCL); also elsewhere on the board
I2C1_SDA: U12.8 (SDA); also elsewhere on the board
unnamed: J3.1, Q2.3 (D)
unnamed: JP1.1 (A), Q2.2 (S)
unnamed: Q2.1 (G), R6.1
unnamed: L3.2, U11.9 (L1)
unnamed: L3.1, U11.7 (L2)
unnamed: C60.1, R32.1, USB1.S1 (SHIELD)
USB_DN: R31.2; also elsewhere on the board
USB_DP: R30.2; also elsewhere on the board
VBAT: C47.1, C61.1, C67.1, JP1.2 (B), Q1.3 (D), TP3.1 (1_1), U12.2 (CELL), U12.3 (VDD), bat-man1.3 (V_{BAT}), bat-man1.4 (V_{BAT})
VBUS: C46.2, D7.2 (A), D8.1 (K), F2.2, Q1.1 (G), R5.1, R22.2, R36.1, bat-man1.1 (V_{DD}), bat-man1.2 (V_{DD})
VBUS_SENSE: R5.2, R7.1; also elsewhere on the board
VSYS: C62.1, D7.1 (K), JP6.1 (A), Q1.2 (S), R39.1, TP2.1 (1_1), U11.10 (VIN); also elsewhere on the board
VS_EN: R8.1, U13.3 (EN), U14.3 (EN); also elsewhere on the board

Notes on the sheet:
Buck-Boost Converter
Fuel Gauge
Power Path
Circuit protection
Power notes (plans/usb-power.md): - Load sharing: VBUS -> D7 -> VSYS with USB, VBAT -> Q1 -> VSYS on battery (Q1 gate on VBUS). The charger only sees the battery, so it terminates. - Q2: battery reverse-polarity guard (drain on J3, gate to GND via R6). The gauge reads ~5-30 mV off under load. - JP3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
Battery Management
Regulation (LDO)
Adafruit is using a 5K resistor for r21, which gives less current (196 instead of 50mA) in the IBat => slower charge but less heat and some small batteries can be dammaged by too much current. Need to adjust once we chose the battery.
