Leo-Nicolle/opentone/hardware/opentone/opentone.kicad_pcb

## KiCad design hardware/opentone/opentone.kicad_pcb (continued)

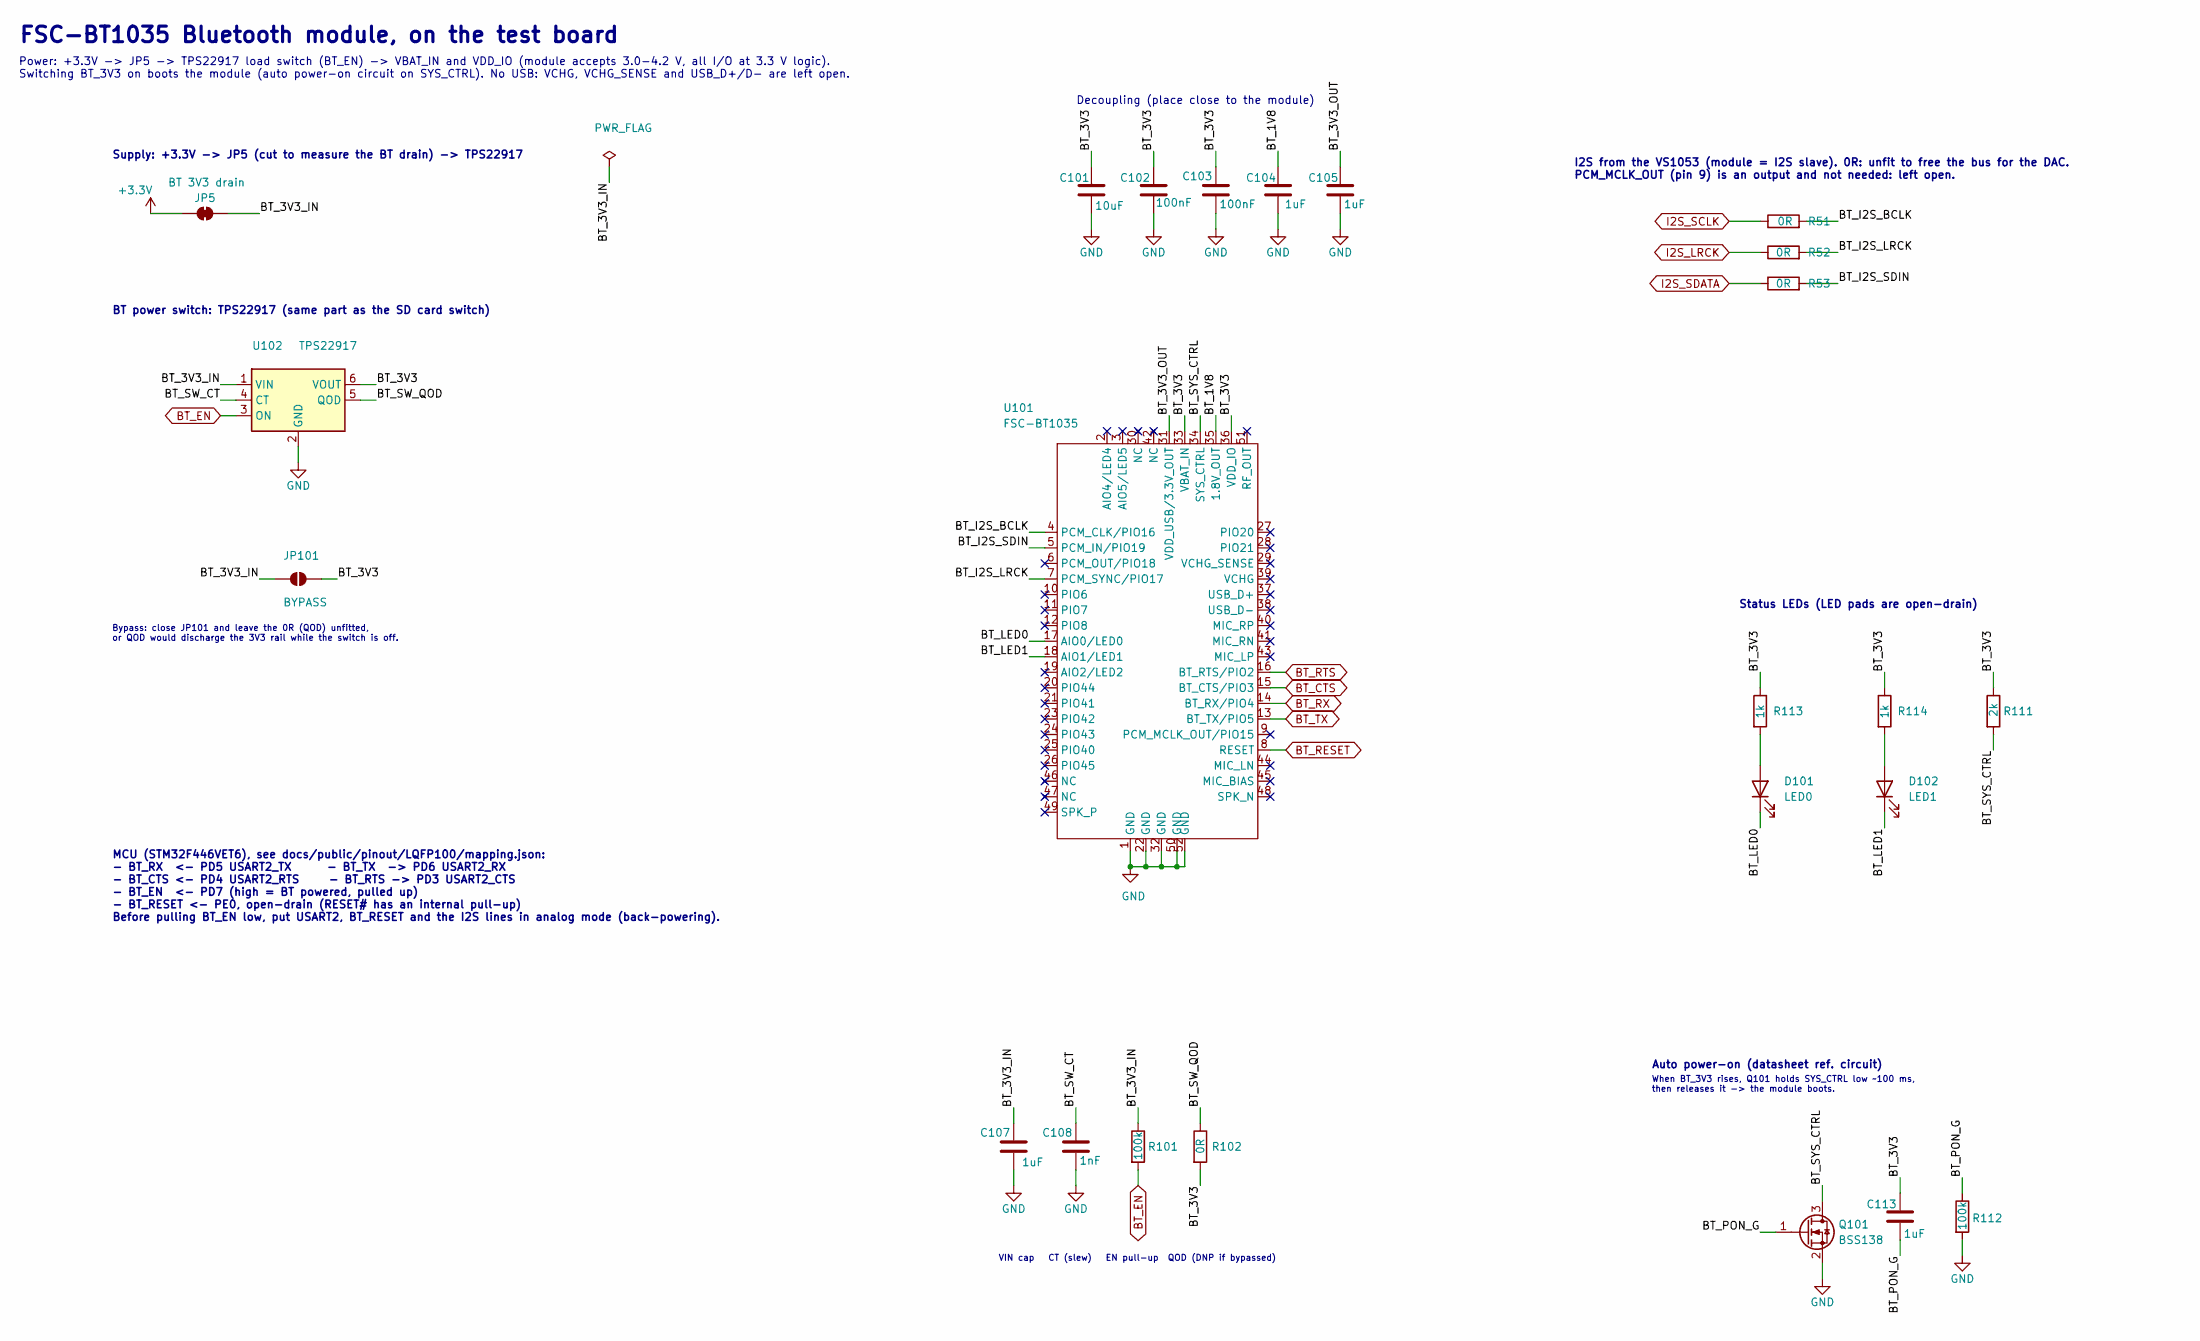
[picture p10: schematic bluetooth.kicad_sch, Bluetooth (FSC-BT1035)]

Parts:
C101: 10uF; C_0603_1608Metric; Part number CL10A106KP8NNNC; LCSC C19702
C102, C103: 100nF; C_0603_1608Metric; Part number CC0603KRX7R9BB104; LCSC C14663
C104, C105, C107, C113: 1uF; C_0603_1608Metric; Part number CL10A105KB8NNNC; LCSC C15849
C108: 1nF; C_0603_1608Metric; Part number CL10B102KB8NNNC; LCSC C1588
D101: LED0; LED_0603_1608Metric; Part number KT-0603R; LCSC C2286
D102: LED1; LED_0603_1608Metric; Part number KT-0603R; LCSC C2286
JP5: BT 3V3 drain; SolderJumper-2_P1.3mm_Bridged_RoundedPad1.0x1.5mm
JP101: BYPASS; SolderJumper-2_P1.3mm_Open_RoundedPad1.0x1.5mm
Q101: BSS138; SOT-23; Part number BSS138LT1G; LCSC C82045
R51, R52, R53, R102: 0R; R_0603_1608Metric; Part number 0603WAF0000T5E; LCSC C21189
R101, R112: 100k; R_0603_1608Metric; Part number 0603WAF1003T5E; LCSC C25803
R111: 2k; R_0603_1608Metric; Part number 0603WAF2001T5E; LCSC C22975
R113, R114: 1k; R_0603_1608Metric; Part number 0603WAF1001T5E; LCSC C21190
U101: FSC-BT1035; fsc-bt1035; Part number FSC-BT1035
U102: TPS22917; SOT-23-6; Part number TPS22917DBVR; LCSC C2681320

Connections:
+3.3V: JP5.1 (A); also elsewhere on the board
/Bluetooth/BT_1V8: C104.1, U101.35 (1.8V_OUT)
/Bluetooth/BT_3V3: C101.1, C102.1, C103.1, C113.1, JP101.2 (B), R102.2, R111.1, R113.1, R114.1, U101.33 (VBAT_IN), U101.36 (VDD_IO), U102.6 (VOUT)
/Bluetooth/BT_3V3_IN: C107.1, JP5.2 (B), JP101.1 (A), R101.1, U102.1 (VIN)
/Bluetooth/BT_3V3_OUT: C105.1, U101.31 (VDD_USB/3.3V_OUT)
/Bluetooth/BT_I2S_BCLK: R51.2, U101.4 (PCM_CLK/PIO16)
/Bluetooth/BT_I2S_LRCK: R52.2, U101.7 (PCM_SYNC/PIO17)
/Bluetooth/BT_I2S_SDIN: R53.2, U101.5 (PCM_IN/PIO19)
/Bluetooth/BT_LED0: D101.1 (K), U101.17 (AIO0/LED0)
/Bluetooth/BT_LED1: D102.1 (K), U101.18 (AIO1/LED1)
/Bluetooth/BT_PON_G: C113.2, Q101.1 (G), R112.1
/Bluetooth/BT_SW_CT: C108.1, U102.4 (CT)
/Bluetooth/BT_SW_QOD: R102.1, U102.5 (QOD)
/Bluetooth/BT_SYS_CTRL: Q101.3 (D), R111.2, U101.34 (SYS_CTRL)
BT_CTS: U101.15 (BT_CTS/PIO3); also elsewhere on the board
BT_EN: R101.2, U102.3 (ON); also elsewhere on the board
BT_RESET: U101.8 (RESET); also elsewhere on the board
BT_RTS: U101.16 (BT_RTS/PIO2); also elsewhere on the board
BT_RX: U101.14 (BT_RX/PIO4); also elsewhere on the board
BT_TX: U101.13 (BT_TX/PIO5); also elsewhere on the board
GND: C101.2, C102.2, C103.2, C104.2, C105.2, C107.2, C108.2, Q101.2 (S), R112.2, U101.1 (GND), U101.22 (GND), U101.32 (GND), U101.50 (GND), U101.52 (GND), U102.2 (GND); also elsewhere on the board
I2S_LRCK: R52.1; also elsewhere on the board
I2S_SCLK: R51.1; also elsewhere on the board
I2S_SDATA: R53.1; also elsewhere on the board
unnamed: D101.2 (A), R113.2
unnamed: D102.2 (A), R114.2

Notes on the sheet:
I2S from the VS1053 (module = I2S slave). 0R: unfit to free the bus for the DAC. PCM_MCLK_OUT (pin 9) is an output and not needed: left open.
VIN cap CT (slew) EN pull-up QOD (DNP if bypassed)
When BT_3V3 rises, Q101 holds SYS_CTRL low ~100 ms, then releases it -> the module boots.
MCU (STM32F446VET6), see docs/public/pinout/LQFP100/mapping.json: - BT_RX <- PD5 USART2_TX - BT_TX -> PD6 USART2_RX - BT_CTS <- PD4 USART2_RTS - BT_RTS -> PD3 USART2_CTS - BT_EN <- PD7 (high = BT powered, pulled up) - BT_RESET <- PE0, open-drain (RESET# has an internal pull-up) Before pulling BT_EN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
Supply: +3.3V -> JP5 (cut to measure the BT drain) -> TPS22917
Auto power-on (datasheet ref. circuit)
Status LEDs (LED pads are open-drain)
Power: +3.3V -> JP5 -> TPS22917 load switch (BT_EN) -> VBAT_IN and VDD_IO (module accepts 3.0-4.2 V, all I/O at 3.3 V logic). Switching BT_3V3 on boots the module (auto power-on circuit on SYS_CTRL). No USB: VCHG, VCHG_SENSE and USB_D+/D- are left open.
Bypass: close JP101 and leave the 0R (QOD) unfitted, or QOD would discharge the 3V3 rail while the switch is off.
BT power switch: TPS22917 (same part as the SD card switch)
FSC-BT1035 Bluetooth module, on the test board
Decoupling (place close to the module)

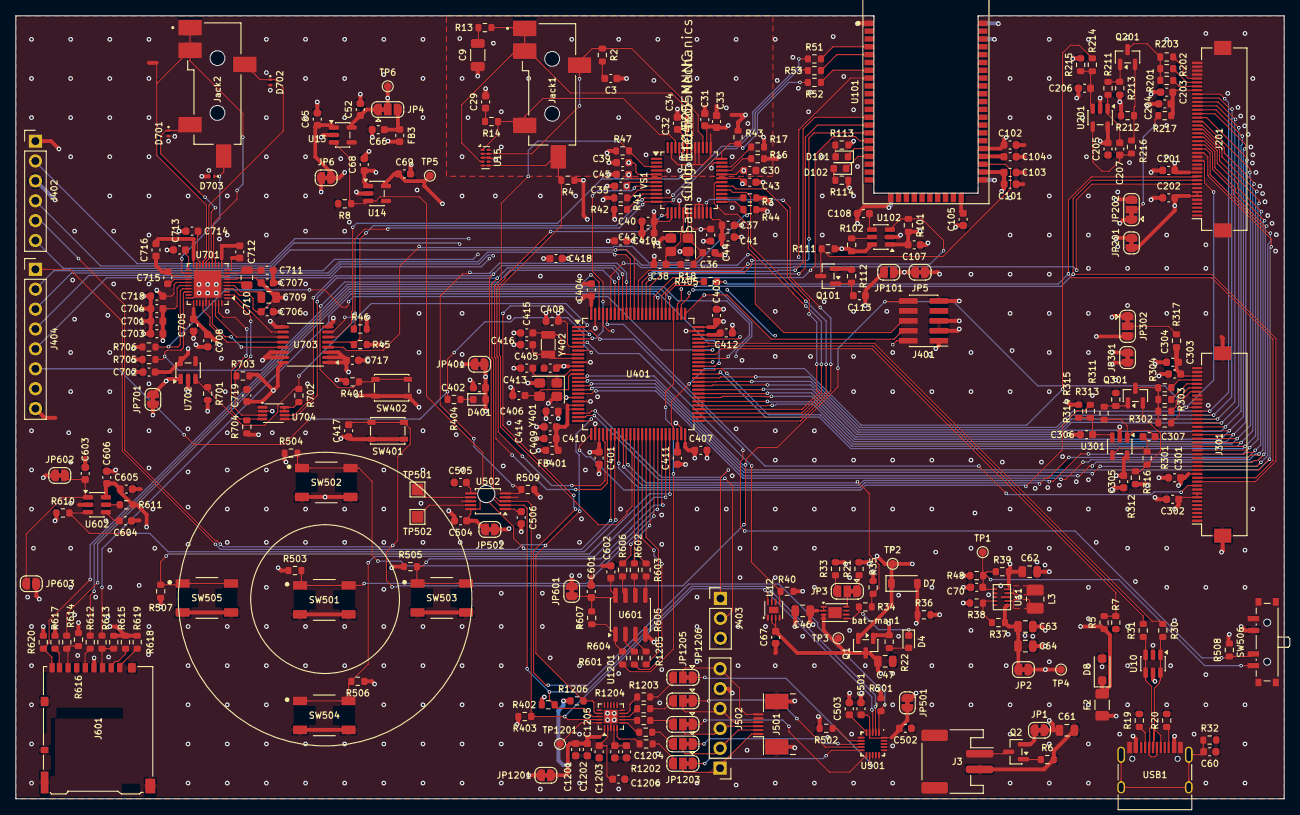
[picture p11: board opentone.kicad_pcb from above]

Board: 4 copper layers, 162.0 x 100.0 mm, 319 parts (0 on the bottom side), 248 nets.
