Leo-Nicolle/opentone/(commit log)

2026-10-18 reworked power schematics
2026-10-18 wiring main MCU
2026-10-18 updated buttons and MCU
2026-10-22 updated BOM
2026-10-27 wire the main MCU caps
2026-10-27 wired screens and vs1053
2026-10-27 better click wheel designer
2026-10-30 update clickwheel footprint and wired the board more
2026-10-30 low power note
2026-10-30 added plans for new capacitive IC and clickwheel sensing
2026-10-31 case designer scafolding
2026-11-07 more routing: screens and SPI of the VS1053
2026-11-07 try to route the analog power routes
2026-11-08 finish reroute: DRC clean and fully connected
    All parts on F.Cu, two track widths and two via sizes, solid In1 GND.
    Adds GND/GNDA stitching, I2S_LRCK moved to B.Cu to remove the GNDA
    island, and DRC rules for the final routing. Documents the layout
    rules in notes/pcb-guidelines.md.
2026-11-08 fixed silkscreen placements
2026-11-08 almost ready for FAB, just need holes for the clickwheel
2026-11-08 link 3D models from the project, remove old board backups
    Keep the STEP models in hardware/opentone/3dmodels and point every
    footprint at them with KIPRJMOD. Models come from the KiCad library,
    or from EasyEDA where the library has none. Drop the old .pre-* files.
2026-11-08 stop tracking 3D models we cannot redistribute, credit KiCad models
    Untrack the EasyEDA models, the Alps copy and the SnapMagic jack model,
    and add a script to fetch the EasyEDA ones. Add the source and license
    of the KiCad models, and list all of this in THIRD_PARTY.md.
